usern4mehere9/LVPSU/README.md

# LVPSU
Low Voltage Power Supply Unit of Formula Student team "Black Hornets" from the University of Novi Sad Faculty of Technical Sciences
