usern4mehere9/LVPSU/LV_Kontrola_Main/README.md

# LV\_Kontrola

Low Voltage Power Supply Unit of Formula Student team "Black Hornets" from the University of Novi Sad Faculty of Technical Sciences

1. LV\_Kontrola\_Main connectors:

2\. LV\_Kontrola\_Infeed\_Battery connectors:

3\. LV\_Kontrola\_Start connectors:

START\_PWR:

1	\[GND]	GND\_START

2	\[GND]	GND\_START

3	\[GND]	GND\_START

4	\[GND]	GND\_START

5	\[VCC]	VCC\_START

6	\[VCC]	VCC\_START

7	\[VCC]	VCC\_START

8	\[VCC]	VCC\_START

COM:

1	\[GND]	GND\_START

2	\[COM]	RS485-B

3	\[GND]	GND\_START

4	\[COM]	RS485-A

START\_OUT\_A:

1	\[VCC]	5V4\_ISO\_1

2	\[GND]	GND\_ISO\_1

3	\[VCC]	5V4\_ISO\_2

4	\[GND]	GND\_ISO\_2

5	\[VCC]	5V4\_ISO\_3

6	\[GND]	GND\_ISO\_3

7	\[VCC]	5V4\_ISO\_4

8	\[GND]	GND\_ISO\_4

9	\[VCC]	3V7\_ISO\_1

10	\[GND]	GND\_ISO\_1

11	\[VCC]	3V7\_ISO\_2

12	\[GND]	GND\_ISO\_2

13	\[VCC]	3V7\_ISO\_3

14	\[GND]	GND\_ISO\_3

15	\[VCC]	3V7\_ISO\_4

16	\[GND]	GND\_ISO\_4

START\_OUT\_B:

1	\[VCC]	5V4\_ISO\_8

2	\[GND]	GND\_ISO\_8

3	\[VCC]	5V4\_ISO\_7

4	\[GND]	GND\_ISO\_7

5	\[VCC]	5V4\_ISO\_6

6	\[GND]	GND\_ISO\_6

7	\[VCC]	5V4\_ISO\_5

8	\[GND]	GND\_ISO\_5

9	\[VCC]	3V7\_ISO\_8

10	\[GND]	GND\_ISO\_8

11	\[VCC]	3V7\_ISO\_7

12	\[GND]	GND\_ISO\_7

13	\[VCC]	3V7\_ISO\_6

14	\[GND]	GND\_ISO\_6

15	\[VCC]	3V7\_ISO\_5

16	\[GND]	GND\_ISO\_5
