usern4mehere9/LVPSU/LV_Regulator/README.md

# LV\_Regulator

Low Voltage Power Supply Unit of Formula Student team "Black Hornets" from the University of Novi Sad Faculty of Technical Sciences

LV\_Regulator connectors:

PWR\_IN:

1	\[GND]	BAT-

2	\[GND]	BAT-

3	\[GND]	BAT-

4	\[GND]	BAT-

5	\[VCC]	BAT+

6	\[VCC]	BAT+

7	\[VCC]	BAT+

8	\[VCC]	BAT+

COM:

1	\[COM]	RS485-B

2	\[COM]	RS485-A

3	\[GND]	GND\_ISO

4	\[VCC]	+5V\_ISO

START:

1	\[GND]	GND

2	\[GND]	GND

3	\[VCC]	5V\_EXT

4	\[VCC]	3V3\_EXT

PWR\_OUT:

1	\[VCC]	VOUT

2	\[VCC]	VOUT

3	\[VCC]	VOUT

4	\[VCC]	VOUT

5	\[GND]	GND

6	\[GND]	GND

7	\[GND]	GND

8	\[GND]	GND
