usern4mehere9/LVPSU/Documentation/00-About.md

This folder is to be used for general documentation about the Low Voltage Power Supply
