usern4mehere9/LVPSU/LV_Regulator/Code/00-About.md

This folder is to be used for code files of the Low Voltage Power Supply regulator board
