usern4mehere9/LVPSU/LV_Regulator/Documentation/00-About.md

This folder is to be used for documentation about the Low Voltage Power Supply regulator board
