usern4mehere9/LVPSU/LV_Kontrola_Main/LV_Kontrola/Documentation/00-About.md

This folder is to be used for documentation about the Low Voltage Power Supply control board
