usern4mehere9/LVPSU/LV_Regulator/LV_Regulator/Components/00-About.md

This folder is to be used for component files of the Low Voltage Power Supply regulator board
