usern4mehere9/LVPSU/LV_Regulator/LV_Regulator/Manufacture/LV_Regulator_BoM.xlsx

Id | Designator | Footprint | Quantity | Designation | Supplier and ref
1 | 3V3 | LED_1206_3216Metric_Pad1.42x1.75mm_HandSolder | 1 | 3V3 (YELLOW) | https://www.digikey.com/en/products/detail/kingbright/APT3216YC/1747544 | https://eu.mouser.com/ProductDetail/Bivar/SM1206UYC?qs=jaLxTFIJCiuXlzWxYf0ziw%3D%3D
2 | 3V3_EXT | LED_1206_3216Metric_Pad1.42x1.75mm_HandSolder | 1 | 3V3_EXT (YELLOW) | https://www.digikey.com/en/products/detail/kingbright/APT3216YC/1747544 | https://eu.mouser.com/ProductDetail/Bivar/SM1206UYC?qs=jaLxTFIJCiuXlzWxYf0ziw%3D%3D
3 | 3V3_INT | LED_1206_3216Metric_Pad1.42x1.75mm_HandSolder | 1 | 3V3_INT (YELLOW) | https://www.digikey.com/en/products/detail/kingbright/APT3216YC/1747544 | https://eu.mouser.com/ProductDetail/Bivar/SM1206UYC?qs=jaLxTFIJCiuXlzWxYf0ziw%3D%3D
4 | 5V | LED_1206_3216Metric_Pad1.42x1.75mm_HandSolder | 1 | 5V (RED) | https://www.digikey.com/en/products/detail/kingbright/APT3216EC/1747854 | https://eu.mouser.com/ProductDetail/Bivar/SM1206URC?qs=jaLxTFIJCitAzd1qr2%2F7Jw%3D%3D
5 | 5V_EXT | LED_1206_3216Metric_Pad1.42x1.75mm_HandSolder | 1 | 5V_EXT (RED) | https://www.digikey.com/en/products/detail/kingbright/APT3216EC/1747854 | https://eu.mouser.com/ProductDetail/Bivar/SM1206URC?qs=jaLxTFIJCitAzd1qr2%2F7Jw%3D%3D
6 | 5V_INT | LED_1206_3216Metric_Pad1.42x1.75mm_HandSolder | 1 | 5V_INT (RED) | https://www.digikey.com/en/products/detail/kingbright/APT3216EC/1747854 | https://eu.mouser.com/ProductDetail/Bivar/SM1206URC?qs=jaLxTFIJCitAzd1qr2%2F7Jw%3D%3D
7 | C1, C2, C13, C14, C17, C18, C22, C24, C25 | C_1206_3216Metric_Pad1.33x1.80mm_HandSolder | 9 | 100nF | https://www.digikey.com/en/products/detail/kemet/c1206y104k9ractu/5879215 | https://eu.mouser.com/ProductDetail/KEMET/C1206Y104K9RACTU?qs=rUPLZ6nenJPIO9Oy%2FdArjw%3D%3D
8 | C3, C5, C19 | C_1206_3216Metric_Pad1.33x1.80mm_HandSolder | 3 | 0.1uF | https://www.digikey.com/en/products/detail/kemet/c1206y104k9ractu/5879215 | https://eu.mouser.com/ProductDetail/KEMET/C1206Y104K9RACTU?qs=rUPLZ6nenJPIO9Oy%2FdArjw%3D%3D
9 | C4, C6, C7, C10, C23 | C_1206_3216Metric_Pad1.33x1.80mm_HandSolder | 5 | 10uF | https://www.digikey.com/en/products/detail/samsung-electro-mechanics/CL31A106KQHNNWE/3888701 | https://eu.mouser.com/ProductDetail/Samsung-Electro-Mechanics/CL31A106KQHNNWE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
10 | C8, C11 | C_1206_3216Metric_Pad1.33x1.80mm_HandSolder | 2 | 47uF | https://www.digikey.com/en/products/detail/taiyo-yuden/MSASJ319LB5476MTNA01/22215176 | https://eu.mouser.com/ProductDetail/TAIYO-YUDEN/MLASJ319LB5476MTNA01?qs=tlsG%2FOw5FFj12GZbAd1Q9Q%3D%3D
11 | C9, C12 | C_1206_3216Metric_Pad1.33x1.80mm_HandSolder | 2 | 22uF | https://www.digikey.com/en/products/detail/murata-electronics/GCM31CD70J226KE02K/19115941 | https://eu.mouser.com/ProductDetail/Murata-Electronics/GGM31CD70J226KE02L?qs=efUn273yAheMi1mARkgjog%3D%3D
12 | C15, C20 | C_1206_3216Metric_Pad1.33x1.80mm_HandSolder | 2 | 8pF | https://www.digikey.com/en/products/detail/cal-chip-electronics-inc/GMC31CG8R0C50NT/25975036 | https://eu.mouser.com/ProductDetail/Walsin/1206N8R0B500CT?qs=ZrPdAQfJ6DNlIoaP9IseAQ%3D%3D
13 | C16, C21 | C_1206_3216Metric_Pad1.33x1.80mm_HandSolder | 2 | 12pF | https://www.digikey.com/en/products/detail/kyocera-avx/KGM31BCG1H120KT/1604417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 | https://eu.mouser.com/ProductDetail/KYOCERA-AVX/12065A120KAT2A?qs=KpoduxKdAk27g2uMv0%2FA4w%3D%3D
14 | C26, C27, C35, C36 | C_1206_3216Metric | 4 | 100nF | https://www.digikey.com/en/products/detail/kemet/c1206y104k9ractu/5879215 | https://eu.mouser.com/ProductDetail/KEMET/C1206Y104K9RACTU?qs=rUPLZ6nenJPIO9Oy%2FdArjw%3D%3D
15 | C28, C37 | C_1206_3216Metric | 2 | 4.7uF | https://www.digikey.com/en/products/detail/samsung-electro-mechanics/CL31B475KAHNNNE/3886713 | https://eu.mouser.com/ProductDetail/Walsin/SH31B475K250CT
16 | C29, C30 | C_1206_3216Metric | 2 | 1uF | https://www.digikey.com/en/products/detail/cal-chip-electronics-inc/GMT31X7R105K100NT2/26921703 | https://eu.mouser.com/ProductDetail/KEMET/C1206C105K1RAC7210?qs=u4fy%2FsgLU9Mgl3I%252Br1mPaw%3D%3D
17 | C31 | CAP_UCD_12P5X13P5_NCH | 1 | 56uF | https://www.digikey.com/en/products/detail/eaton-electronics-division/EHBSA080M5601010T/26408296 | https://eu.mouser.com/ProductDetail/Eaton-Electronics/EHBSA080M5601010T
18 | C32, C33 | CP_Elec_10x10 | 2 | 47uF | https://www.digikey.com/en/products/detail/vishay-beyschlag-draloric-bc-components/MAL214097801E3/5634876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 | https://eu.mouser.com/ProductDetail/Vishay-BC-Components/MAL214097801E3
19 | C34 | CAP_UCD_12P5X13P5_NCH | 1 | 180uF | https://www.digikey.com/en/products/detail/nichicon/ucz1j181mns1ms/13402701 | https://eu.mouser.com/ProductDetail/Nichicon/UCZ1J181MNS1MS?qs=DPoM0jnrROWw1nmvs2XGyw%3D%3D
20 | COM, START | CONN_SD-43045-001_04_MOL | 2 | 430450400 | https://www.digikey.com/en/products/detail/molex/0430450400/252527?s=N4IgTCBcDaICwGYAMcCsKlJAXQL5A | https://eu.mouser.com/ProductDetail/Molex/43045-0400?qs=UeCeOHRHQeaIqmxE9Bxdrw%3D%3D
21 | D1 | D_1206_3216Metric_Pad1.42x1.75mm_HandSolder | 1 | 1N4148 | https://www.digikey.com/en/products/detail/taiwan-semiconductor-corporation/1N4148WH-RHG/26257442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 | https://eu.mouser.com/ProductDetail/Taiwan-Semiconductor/1N4148WH-RHG?qs=jcD%2FCkGBYeO25pFAgr5eQA%3D%3D
22 | D2, D3, D4, D5, D6, D7 | CR_SMA_403AE_OSI | 6 | SS14 | https://www.digikey.com/en/products/detail/onsemi/SS14/965474 | https://eu.mouser.com/ProductDetail/onsemi/SS14?qs=mVVXn4M53U%252BvrBaFv5vr4w%3D%3D
23 | D8, D9 | D_1206_3216Metric_Pad1.42x1.75mm_HandSolder | 2 | LED(YELLOW) | https://www.digikey.com/en/products/detail/kingbright/APT3216YC/1747544 | https://eu.mouser.com/ProductDetail/Bivar/SM1206UYC?qs=jaLxTFIJCiuXlzWxYf0ziw%3D%3D
24 | DIAG | MOLEX_2169890001 | 1 | 2169890001 | https://www.digikey.com/en/products/detail/wec/216989-0001/29353332 | https://eu.mouser.com/ProductDetail/Molex/216989-0001?qs=DRkmTr78QARfehpd11NNIg%3D%3D
25 | ERR | LED_1206_3216Metric_Pad1.42x1.75mm_HandSolder | 1 | ERR(RED) | https://www.digikey.com/en/products/detail/kingbright/APT3216EC/1747854 | https://eu.mouser.com/ProductDetail/Bivar/SM1206URC?qs=jaLxTFIJCitAzd1qr2%2F7Jw%3D%3D
26 | F1 | Fuse_1206_3216Metric_Pad1.42x1.75mm_HandSolder | 1 | 8A | https://www.digikey.com/en/products/detail/bel-fuse-inc/C1F-8/4968262 | https://eu.mouser.com/ProductDetail/Bel-Fuse/C1F-8?qs=Mr%252BgrRYddfrdVmWsT7iZqg%3D%3D
27 | F2 | Fuse_1206_3216Metric_Pad1.42x1.75mm_HandSolder | 1 | 10A | https://www.digikey.com/en/products/detail/bel-fuse-inc/0685P9100-01/10057383 | https://eu.mouser.com/ProductDetail/Bel-Fuse/0685P9100-01?qs=vLWxofP3U2zpPXwWmInB2A%3D%3D
28 | F3, F4 | Fuse_1206_3216Metric_Pad1.42x1.75mm_HandSolder | 2 | 1A | https://www.digikey.com/en/products/detail/bel-fuse-inc/C1F-1/4968247 | https://eu.mouser.com/ProductDetail/Bel-Fuse/C1F-1?qs=Mr%252BgrRYddfo0MDG0o75HAg%3D%3D
29 | IC1 | SOIC127P1030X265-16N | 1 | UCC12040DVE | https://www.digikey.com/en/products/detail/texas-instruments/UCC12040DVE/11502272 | https://eu.mouser.com/ProductDetail/Texas-Instruments/UCC12040DVE?qs=xZ%2FP%252Ba9zWqaWnn41WPN4Eg%3D%3D
30 | IC2, IC3 | MIC29152WU | 2 | MIC29152WU | https://www.digikey.com/en/products/detail/microchip-technology/MIC29152WU/1029053 | https://eu.mouser.com/ProductDetail/Microchip-Technology/MIC29152WU?qs=kh6iOki%2FeLHeF19%2FNG7LNg%3D%3D
31 | J3, PWR_IN | CONN_SD-43045-001_08_MOL | 2 | 430450800 | https://www.digikey.com/en/products/detail/molex/0430450800/252529?s=N4IgTCBcDaICwGYAMcCsSAcSkgLoF8g | https://eu.mouser.com/ProductDetail/Molex/43045-0800?qs=MGlPTwjtJ4Z70Z3DbkGxKw%3D%3D
32 | K1 | LED_1206_3216Metric_Pad1.42x1.75mm_HandSolder | 1 | REL(GREEN) | https://www.digikey.com/en/products/detail/kingbright/APT3216SGC/1747540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 | https://eu.mouser.com/ProductDetail/Bivar/SM1206GC?qs=jaLxTFIJCisAdwYMDid7AA%3D%3D
33 | K1 | 415000000000 | 1 | 41.52.9.005.0010 | https://elektroleum.rs/proizvod/finder-41-52-9-005-0010-pcb-relej-5-v-dc-8-a-2-prekidac/ | //
34 | L1 | L_APV_APH1770 | 1 | 10uH | https://www.digikey.com/en/products/detail/bourns-inc/srp1770ta-100m/5429634 | https://eu.mouser.com/ProductDetail/Bourns/SRP1770TA-100M?qs=P%2FbxraXw5h21PnFfyxJ6Hw%3D%3D
35 | OK | LED_1206_3216Metric_Pad1.42x1.75mm_HandSolder | 1 | OK (GREEN) | https://www.digikey.com/en/products/detail/kingbright/APT3216SGC/1747540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 | https://eu.mouser.com/ProductDetail/Bivar/SM1206GC?qs=jaLxTFIJCisAdwYMDid7AA%3D%3D
36 | Q1 | SOT-23W_Handsoldering | 1 | BC807 | https://www.digikey.com/en/products/detail/onsemi/BC807-25LT1G/918336 | https://eu.mouser.com/ProductDetail/Rectron/BC807?qs=7pEAo90IqNGz%252BRZEzhTrXg%3D%3D
37 | R1, R3, R42, R43, R44, R45, R46, R47, R48 | R_1206_3216Metric_Pad1.30x1.75mm_HandSolder | 9 | --- | https://www.digikey.com/en/products/detail/yageo/rc1206jr-070rl/729184 | https://eu.mouser.com/ProductDetail/YAGEO/RC1206JR-070RL?qs=sGAEpiMZZMtlubZbdhIBIMHu9P6GKOabM4IOLvph3MY%3D
38 | R2 | R_1206_3216Metric_Pad1.30x1.75mm_HandSolder | 1 | 120 | https://www.digikey.com/en/products/detail/yageo/AC1206FR-07120RL/6006659 | https://eu.mouser.com/ProductDetail/YAGEO/RC1206JR-070RL?qs=sGAEpiMZZMtlubZbdhIBIMHu9P6GKOabM4IOLvph3MY%3D
39 | R4 | R_1206_3216Metric_Pad1.30x1.75mm_HandSolder | 1 | 4k7 | https://www.digikey.com/en/products/detail/yageo/RC1206DR-074K7L/5919134 | https://eu.mouser.com/ProductDetail/YAGEO/RE1206DRE074K7L?qs=sGAEpiMZZMtlubZbdhIBIKm0gsRX2fVkj2duGOZmAAU%3D
40 | R5 | R_1206_3216Metric_Pad1.30x1.75mm_HandSolder | 1 | 33k | https://www.digikey.com/en/products/detail/yageo/rt1206brd0733kl/1079747 | https://eu.mouser.com/ProductDetail/YAGEO/RT1206BRD0733KL
41 | R6, R53, R54 | R_1206_3216Metric_Pad1.30x1.75mm_HandSolder | 3 | 10k | https://www.digikey.com/en/products/detail/rohm-semiconductor/sfr18ezpj103/17139990 | https://eu.mouser.com/ProductDetail/ROHM-Semiconductor/SFR18EZPJ103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
42 | R7 | R_1206_3216Metric_Pad1.30x1.75mm_HandSolder | 1 | 34k | https://www.digikey.com/en/products/detail/panasonic-industry/era-8arw3402v/5163060 | https://eu.mouser.com/ProductDetail/Panasonic/ERA-8ARW3402V
43 | R8, R9, R24 | R_1206_3216Metric_Pad1.30x1.75mm_HandSolder | 3 | 10K | https://www.digikey.com/en/products/detail/rohm-semiconductor/sfr18ezpj103/17139990 | https://eu.mouser.com/ProductDetail/ROHM-Semiconductor/SFR18EZPJ103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
44 | R10, R12, R15 | R_1206_3216Metric_Pad1.30x1.75mm_HandSolder | 3 | 270 | https://www.digikey.com/en/products/detail/panasonic-industry/era-8aeb271v/3070925 | https://eu.mouser.com/ProductDetail/Panasonic/ERA-8AEB271V?qs=Ojoo2rCVP9QMqW%2FU5Qd6jQ%3D%3D
45 | R11, R13, R14, R16, R17, R18, R19, R20, R21 | R_1206_3216Metric_Pad1.30x1.75mm_HandSolder | 9 | 130 | https://www.digikey.com/en/products/detail/panasonic-industry/era-8aeb131v/3070785 | https://eu.mouser.com/ProductDetail/Panasonic/ERA-8AEB131V?qs=Ojoo2rCVP9TrpPj4XUmTEQ%3D%3D
46 | R22, R23 | R_1206_3216Metric_Pad1.30x1.75mm_HandSolder | 2 | 5K1 | https://www.digikey.com/en/products/detail/panasonic-industry/era-8arb512v/5141079 | https://eu.mouser.com/ProductDetail/Panasonic/ERA-8ARB512V?qs=6%252Bc%252B2ke79U5SMWj%2FkMBHmA%3D%3D
47 | R25, R26 | R_1206_3216Metric_Pad1.30x1.75mm_HandSolder | 2 | 27R | https://www.digikey.com/en/products/detail/panasonic-industry/era-8ahd270v/9373454 | https://eu.mouser.com/ProductDetail/Panasonic/ERA-8AHD270V?qs=MNPzkKEzRtQao2AraMolwQ%3D%3D
48 | R27 | R_1206_3216Metric_Pad1.30x1.75mm_HandSolder | 1 | 1K5 | https://www.digikey.com/en/products/detail/panasonic-industry/ERA-8ARB152V/5141066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 | https://eu.mouser.com/ProductDetail/Panasonic/ERA-8ARB152V?qs=O13OCoPxAUUWFoS4GUkTIg%3D%3D
49 | R28 | R_1206_3216Metric_Pad1.30x1.75mm_HandSolder | 1 | 132k | https://www.digikey.com/en/products/detail/vishay-dale/tnpw1206132kbeen/7663890 | https://eu.mouser.com/ProductDetail/Vishay/TNPW1206132KBEEN?qs=vgMJRbWkoi3MjsgVW2XhcQ%3D%3D
50 | R29 | R_1206_3216Metric_Pad1.30x1.75mm_HandSolder | 1 | 67k | https://www.digikey.com/en/products/detail/yageo/rt1206fre0766k5l/1083325 | https://eu.mouser.com/ProductDetail/YAGEO/RT1206FRE0766K5L?qs=yNCrj0CQcyI8FCz1oyla5w%3D%3D
51 | R30 | R_1206_3216Metric_Pad1.30x1.75mm_HandSolder | 1 | 100k | https://www.digikey.com/en/products/detail/koa-speer-electronics-inc/RN73H2BTTD1003B25/10064206 | https://eu.mouser.com/ProductDetail/KOA-Speer/RN73H2BTTD1003B25?qs=G1LhLIAbs1wIuuYtOEogfA%3D%3D
52 | R31 | R_1206_3216Metric_Pad1.30x1.75mm_HandSolder | 1 | 57k | https://www.digikey.com/en/products/detail/panasonic-industry/ERA-8AEB5762V/3071099 | https://eu.mouser.com/ProductDetail/KOA-Speer/RN73H2BTTD5762B50?qs=rI7uf1IzohRjg5ImrTOTZw%3D%3D
53 | R32, R39 | R_1206_3216Metric_Pad1.30x1.75mm_HandSolder | 2 | 1M | https://www.digikey.com/en/products/detail/te-connectivity-passive-product/CRG1206F1M0/2380979 | https://eu.mouser.com/ProductDetail/KOA-Speer/RK73G2BRTTD1004F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
54 | R33 | R_1206_3216Metric_Pad1.30x1.75mm_HandSolder | 1 | 115k | https://www.digikey.com/en/products/detail/yageo/RC1206FR-07115KL/728512 | https://eu.mouser.com/ProductDetail/KOA-Speer/RN73H2BTTD1153F100?qs=egkD4cx1ihRrPVr9m6Kwpw%3D%3D
55 | R34, R36 | R_1206_3216Metric_Pad1.30x1.75mm_HandSolder | 2 | 1k | https://www.digikey.com/en/products/detail/koa-speer-electronics-inc/RN73R2BTTD1001B25/10038824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 | https://eu.mouser.com/ProductDetail/KOA-Speer/RN73R2BTTD1001B25?qs=2WXlatMagcH37CMjW4no9w%3D%3D
56 | R35, R41 | R_1206_3216Metric_Pad1.30x1.75mm_HandSolder | 2 | 22k | https://www.digikey.com/en/products/detail/yageo/RT1206FRD0722KL/21768884 | https://eu.mouser.com/ProductDetail/KOA-Speer/RN73H2BTTD2202F100?qs=egkD4cx1ihQzyZ5aSCTtGw%3D%3D
57 | R37 | R_1206_3216Metric_Pad1.30x1.75mm_HandSolder | 1 | 80k | https://www.digikey.com/en/products/detail/koa-speer-electronics-inc/RN73H2BTTD8062F50/10104981 | https://eu.mouser.com/ProductDetail/KOA-Speer/RN73H2BTTD8062F50?qs=egkD4cx1ihTPwGpTlMv%2FKg%3D%3D
58 | R38 | R_1206_3216Metric_Pad1.30x1.75mm_HandSolder | 1 | 30k | https://www.digikey.com/en/products/detail/yageo/RT1206BRD0730KL/1079730 | https://eu.mouser.com/ProductDetail/KOA-Speer/RN73R2BTTD5002B25?qs=2WXlatMagcHXnQ1HwYzmYA%3D%3D
59 | R40 | R_1206_3216Metric_Pad1.30x1.75mm_HandSolder | 1 | 311k | https://www.digikey.com/en/products/detail/koa-speer-electronics-inc/rn73h2bttd3123f50/10098239 | https://eu.mouser.com/ProductDetail/KOA-Speer/RN73H2BTTD3123F50?qs=egkD4cx1ihSun6G6xPVr3A%3D%3D
60 | R49 | R_1206_3216Metric_Pad1.30x1.75mm_HandSolder | 1 | 2.2k | https://www.digikey.com/en/products/detail/yageo/RT1206DRE072K2L/1082537 | https://eu.mouser.com/ProductDetail/Panasonic/ERA-8AED222V?qs=MNPzkKEzRtQm0146O%252BqXeg%3D%3D
61 | R50 | RESC50110X70N | 1 | 5m | https://www.digikey.com/en/products/detail/ohmite/FCSL110R005FER/2352241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 | https://eu.mouser.com/ProductDetail/Ohmite/FCSL110R005FER?qs=MhoRK8A7%252BtWFd3RnyGifNg%3D%3D
62 | R51, R52 | R_1206_3216Metric_Pad1.30x1.75mm_HandSolder | 2 | 10 | https://www.digikey.com/en/products/detail/panasonic-industry/ERA-8AHD100V/9373445 | https://eu.mouser.com/ProductDetail/Panasonic/ERA-8AHD100V?qs=MNPzkKEzRtQgblvRJLtuOQ%3D%3D
63 | RUN | LED_1206_3216Metric_Pad1.42x1.75mm_HandSolder | 1 | RUN(GREEN) | https://www.digikey.com/en/products/detail/kingbright/APT3216SGC/1747540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 | https://eu.mouser.com/ProductDetail/Bivar/SM1206GC?qs=jaLxTFIJCisAdwYMDid7AA%3D%3D
64 | RX | LED_1206_3216Metric_Pad1.42x1.75mm_HandSolder | 1 | RX(RED) | https://www.digikey.com/en/products/detail/kingbright/APT3216EC/1747854 | https://eu.mouser.com/ProductDetail/Bivar/SM1206URC?qs=jaLxTFIJCitAzd1qr2%2F7Jw%3D%3D
65 | SWD | PinHeader_1x04_P2.54mm_Vertical | 1 | SWD | https://www.digikey.com/en/products/detail/te-connectivity-amp-connectors/826646-2/2276168 | https://eu.mouser.com/ProductDetail/TE-Connectivity/826646-2?qs=6Tj7fpyCzVqaIPUaVSFNTg%3D%3D
66 | TX | LED_1206_3216Metric_Pad1.42x1.75mm_HandSolder | 1 | TX(YELLOW) | https://www.digikey.com/en/products/detail/kingbright/APT3216YC/1747544 | https://eu.mouser.com/ProductDetail/Kingbright/APT3216YC?qs=fKJLI%2FsxXOfMof1%252BHeqe1A%3D%3D
67 | U1 | SOIC-16W_7.5x10.3mm_P1.27mm | 1 | ADM2483xRW | https://www.digikey.com/en/products/detail/analog-devices-inc/ADM2483BRWZ/1007303 | https://eu.mouser.com/ProductDetail/Analog-Devices/ADM2483BRWZ-REEL?qs=BpaRKvA4VqG%252BMd7ITKpptQ%3D%3D
68 | U2 | LQFP-48_7x7mm_P0.5mm | 1 | STM32F103C8Tx | https://www.digikey.com/en/products/detail/stmicroelectronics/STM32F103C8T6/1646338 | https://eu.mouser.com/ProductDetail/STMicroelectronics/STM32F103C8T6?qs=bhCVus9SdFtq6kqxsU5%2FDA%3D%3D
69 | U3 | SOIC-8_3.9x4.9mm_P1.27mm | 1 | 25CSM04xxSN | https://www.digikey.com/en/products/detail/microchip-technology/25CSM04T-I-SN/13174945 | https://eu.mouser.com/ProductDetail/Microchip-Technology/25CSM04T-I-SN?qs=W%2FMpXkg%252BdQ4COJ43XO1dvg%3D%3D
70 | U4 | RRV0036B-IPC_A | 1 | BQ25858QWRRVRQ1 | https://www.digikey.com/en/products/detail/texas-instruments/BQ25858QWRRVRQ1/26639671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 | https://eu.mouser.com/ProductDetail/Texas-Instruments/BQ25858QWRRVRQ1?qs=2FehpBK1j95O8UCrfNTgvw%3D%3D
71 | U5, U6, U7, U8 | DDPAK&slash_TO-263_KTT_TEX | 4 | CSD19506KTT | https://www.digikey.com/en/products/detail/texas-instruments/CSD19506KTT/5970302
72 | Y1 | Crystal_SMD_EuroQuartz_EQ161-2Pin_3.2x1.5mm_HandSoldering | 1 | 32.768kHz | https://www.digikey.com/en/products/detail/seiko-instruments/SC32S-7PF20PPM/4931504 | https://eu.mouser.com/ProductDetail/Seiko-Instruments/SC32A-6PF20PPM?qs=Imq1NPwxi76SI853puRy%252Bw%3D%3D
73 | Y2 | Crystal_SMD_5032-2Pin_5.0x3.2mm_HandSoldering | 1 | 8MHz | https://www.digikey.com/en/products/detail/ecs-inc/ECS-80-8-30-JGN-TR/17139414 | https://eu.mouser.com/ProductDetail/ECS/ECS-80-8-30-JGN-TR?qs=rQFj71Wb1eX34%2FP%2F%2Fw8%2FDA%3D%3D
74
75
76
77
78
79
80
81
82
