usern4mehere9/LVPSU/LV_Regulator/LV_Regulator/Components/LIB_41.52.9.005.0010/41.52.9.005.0010/3D/41.52.9.005.0010.stp

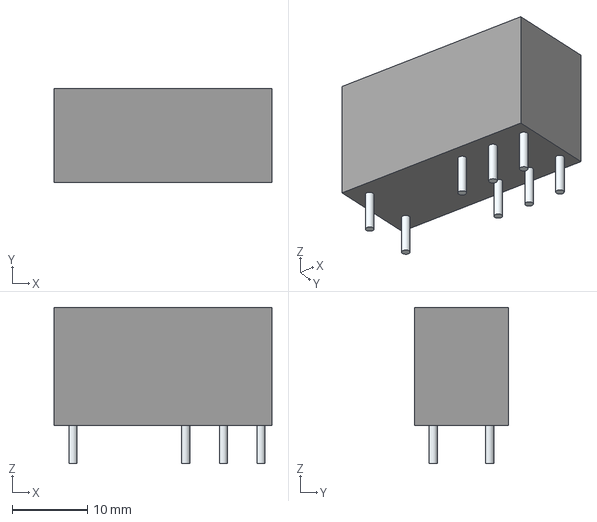
[picture p66: CAD file, 2026-01-20]
LV_Regulator/LV_Regulator/Components/LIB_41.52.9.005.0010/41.52.9.005.0010/3D/41.52.9.005.0010.stp
29.0 x 12.5 x 20.8 mm
Leads
