usern4mehere9/LVPSU/LV_Regulator/LV_Regulator/Components/LIB_FCSL110R005FER/FCSL110R005FER/3D/FCSL110R005FER.stp

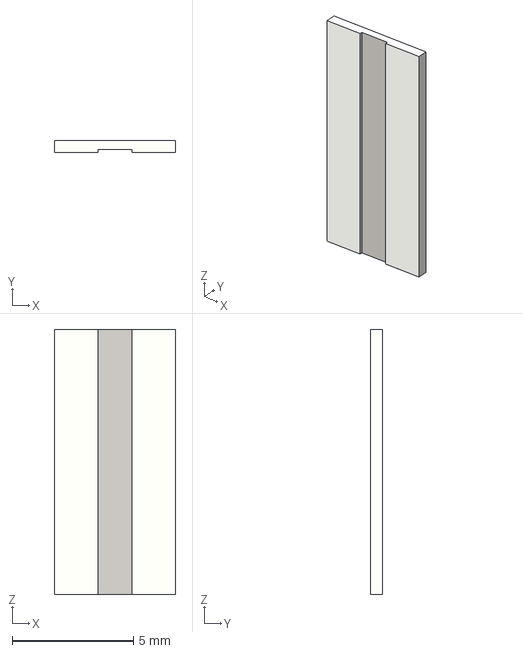
[picture p67: CAD file, 2026-03-20]
LV_Regulator/LV_Regulator/Components/LIB_FCSL110R005FER/FCSL110R005FER/3D/FCSL110R005FER.stp
5.00 x 0.5 x 10.9 mm
