usern4mehere9/LVPSU/LV_Regulator/LV_Regulator/Components/LIB_SC32A-6PF20PPM/SC32A-6PF20PPM/3D/SC32A-6PF20PPM.stp

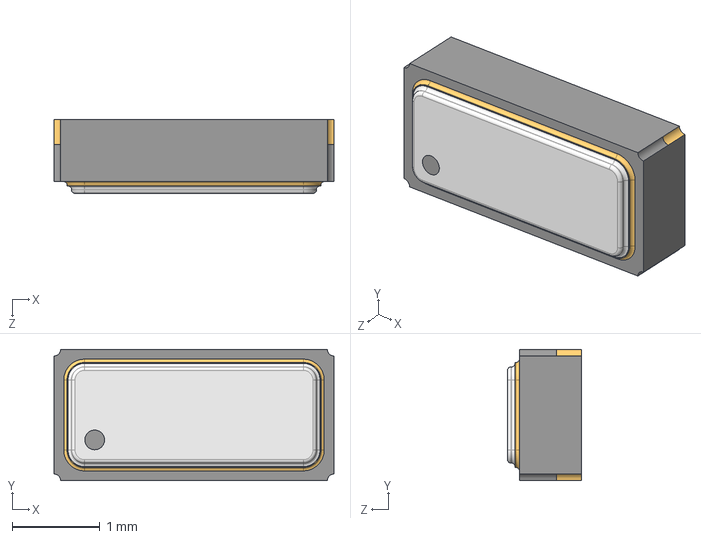
[picture p68: CAD file, 2026-03-29]
LV_Regulator/LV_Regulator/Components/LIB_SC32A-6PF20PPM/SC32A-6PF20PPM/3D/SC32A-6PF20PPM.stp
3.20 x 1.50 x 0.845 mm
