usern4mehere9/LVPSU/LV_Regulator/LV_Regulator/Components/SS14/Schottky Diode.step

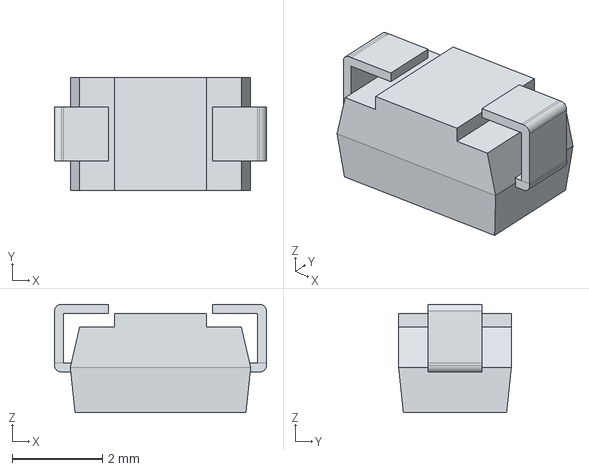
[picture p69: CAD file, 2026-03-29]
LV_Regulator/LV_Regulator/Components/SS14/Schottky Diode.step
4.70 x 2.50 x 2.40 mm
