usern4mehere9/LVPSU/LV_Regulator/LV_Regulator/Components/ul_BQ25858QWRRVRQ1/Texas_RHH0036C_VQFN-36-1EP_6x6mm_P0.5mm_EP4.4x4.4mm.step

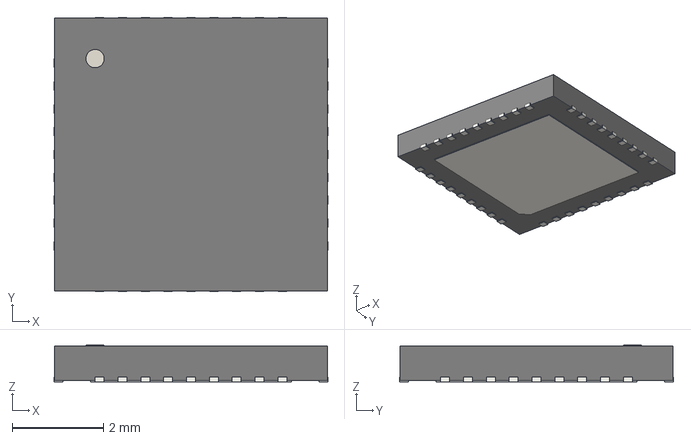
[picture p70: CAD file, 2026-03-28]
LV_Regulator/LV_Regulator/Components/ul_BQ25858QWRRVRQ1/Texas_RHH0036C_VQFN-36-1EP_6x6mm_P0.5mm_EP4.4x4.4mm.step
6.00 x 6.00 x 0.8 mm
