usern4mehere9/LVPSU/LV_Regulator/LV_Regulator/Components/ul_CSD19506KTT/KTT0002A.stp

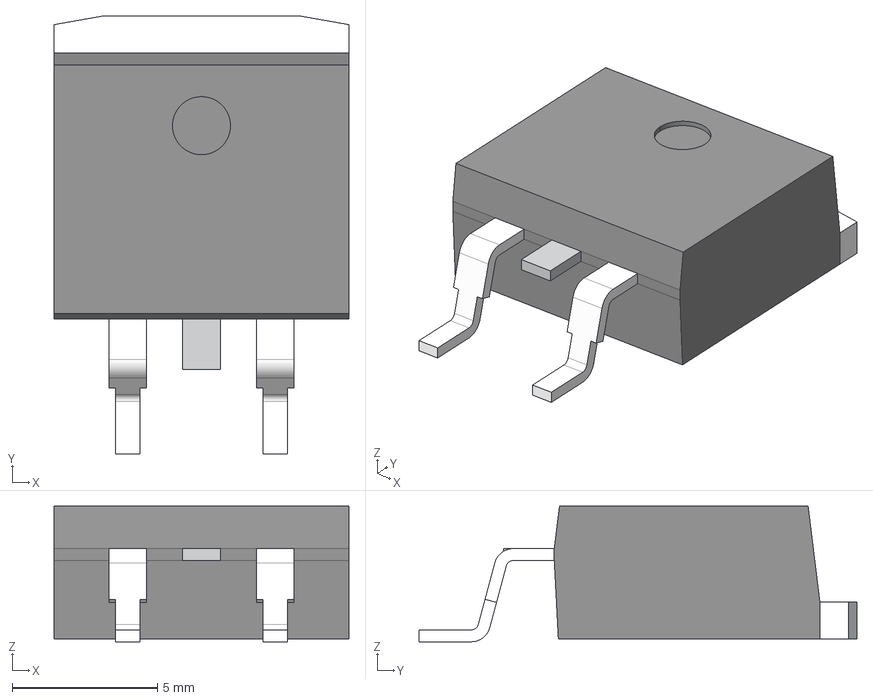
[picture p71: CAD file, 2026-03-28]
LV_Regulator/LV_Regulator/Components/ul_CSD19506KTT/KTT0002A.stp
10.2 x 15.1 x 4.67 mm
BODY-TO263
HTSINK-TO263
LEAD-TO263 x 2
LEAD-MIDDLE
