usern4mehere9/LVPSU/LV_Regulator/LV_Regulator/Components/ul_UCZ1J181MNQ1MS/UCZ1J181MNS1MS_Vibration_resistant.step

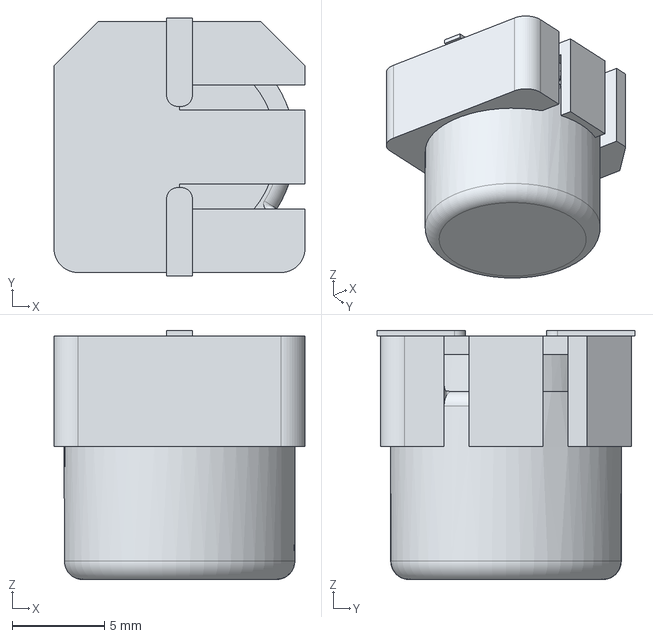
[picture p72: CAD file, 2026-03-29]
LV_Regulator/LV_Regulator/Components/ul_UCZ1J181MNQ1MS/UCZ1J181MNS1MS_Vibration_resistant.step
13.6 x 14.0 x 13.5 mm
