usern4mehere9/LVPSU/LV_Regulator/LV_Regulator/Components/V1FM10-M3_H/LIB_V1FM10-M3_H/V1FM10-M3_H/3D/V1FM10-M3_H.stp

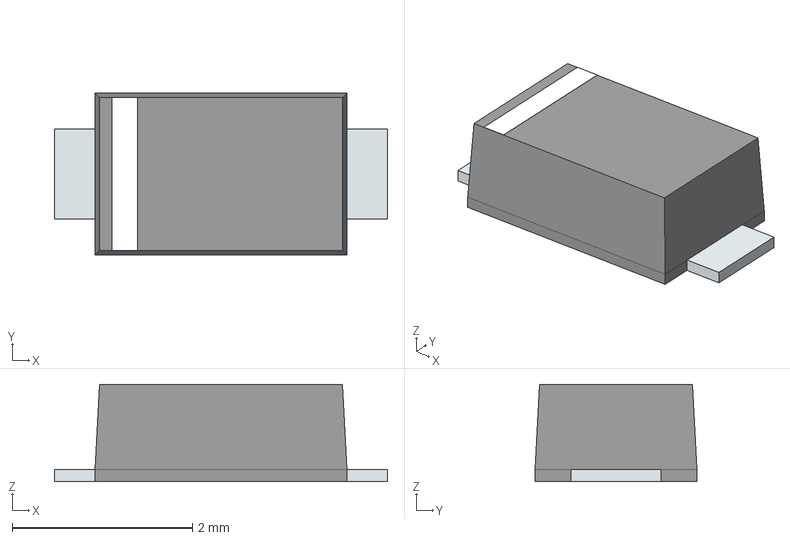
[picture p73: CAD file, 2026-03-27]
LV_Regulator/LV_Regulator/Components/V1FM10-M3_H/LIB_V1FM10-M3_H/V1FM10-M3_H/3D/V1FM10-M3_H.stp
3.70 x 1.80 x 1.08 mm
PinKIdent
PinK
PinA
