usern4mehere9/LVPSU/LV_Regulator/LV_Regulator/Components/ul_BQ25858QWRRVRQ1/QFN-36-1EP_5x6mm_P0.5mm_EP3.6x4.6mm.step

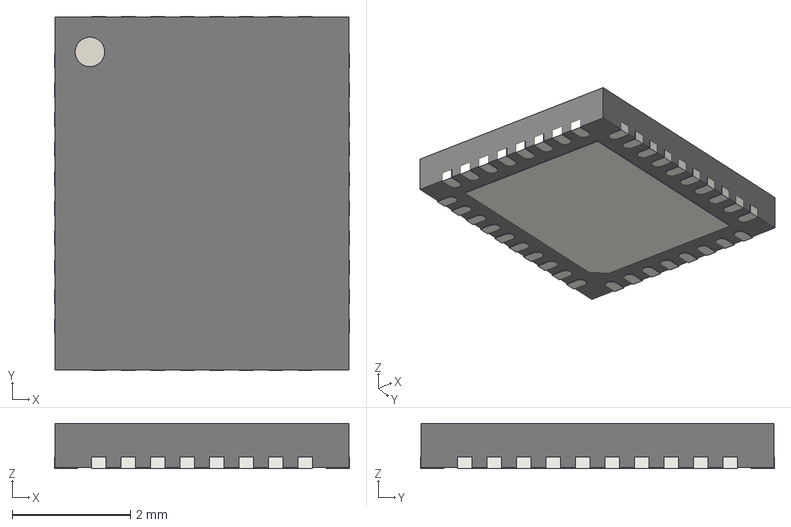
[picture p74: CAD file, 2026-03-28]
LV_Regulator/LV_Regulator/Components/ul_BQ25858QWRRVRQ1/QFN-36-1EP_5x6mm_P0.5mm_EP3.6x4.6mm.step
5.00 x 6.00 x 0.77 mm
