usern4mehere9/LVPSU/LV_Kontrola_Main/LV_Kontrola_Start/LV_Kontrola_Start/Components/430451600/430451600.step

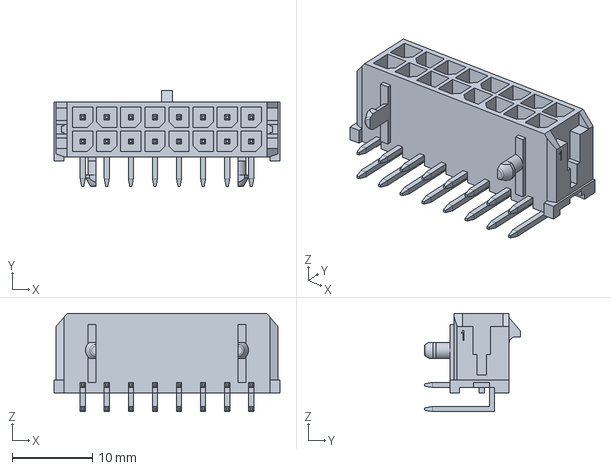
[picture p75: CAD file, 2026-04-07]
LV_Kontrola_Main/LV_Kontrola_Start/LV_Kontrola_Start/Components/430451600/430451600.step
28.2 x 12.0 x 12.2 mm
