usern4mehere9/LVPSU/LV_Kontrola_Main/LV_Kontrola_Start/LV_Kontrola_Start/Components/LIB_MIC29152WU/MIC29152WU/3D/MIC29152WU.stp

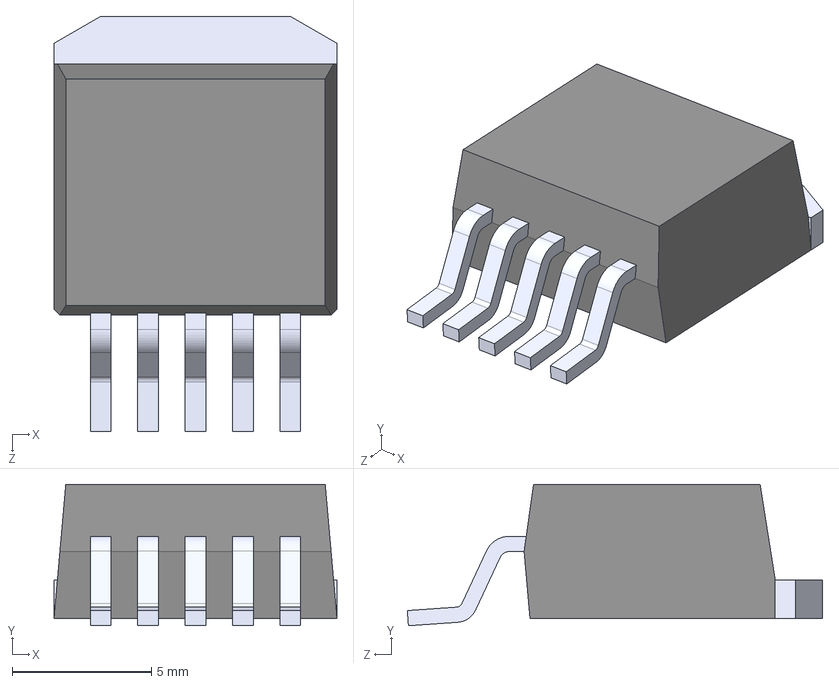
[picture p76: CAD file, 2026-03-18]
LV_Kontrola_Main/LV_Kontrola_Start/LV_Kontrola_Start/Components/LIB_MIC29152WU/MIC29152WU/3D/MIC29152WU.stp
10.2 x 5.08 x 14.9 mm
