usern4mehere9/LVPSU/LV_Kontrola_Main/LV_Kontrola_Start/LV_Kontrola_Start/Components/LIB_UCC12040DVE/UCC12040DVE/3D/UCC12040DVE.stp

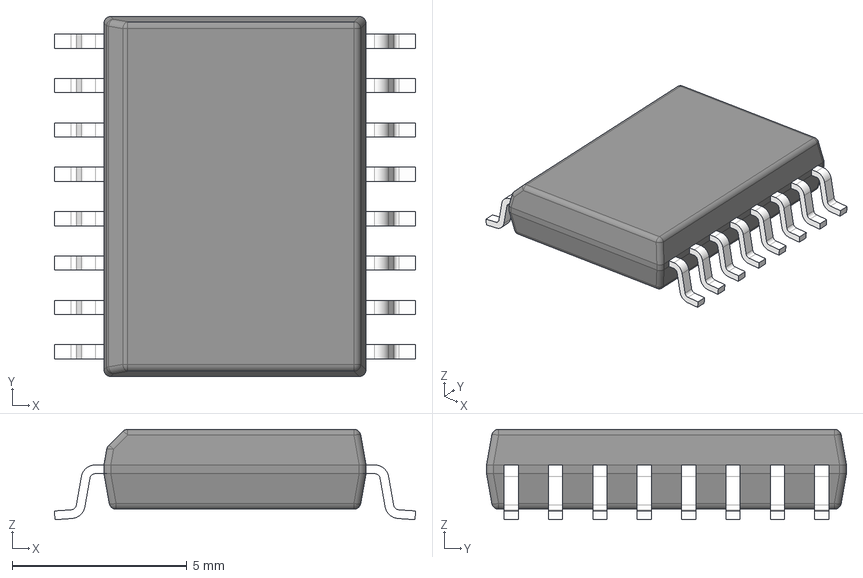
[picture p77: CAD file, 2026-01-20]
LV_Kontrola_Main/LV_Kontrola_Start/LV_Kontrola_Start/Components/LIB_UCC12040DVE/UCC12040DVE/3D/UCC12040DVE.stp
10.3 x 10.3 x 2.59 mm
BODY-DVE0016A
LEAD-DVE0016A x 16
