usern4mehere9/LVPSU/LV_Kontrola_Main/LV_Kontrola_Start/LV_Kontrola_Start/Components/microfit-4pin/430450401--3DModel-STEP-269445.STEP

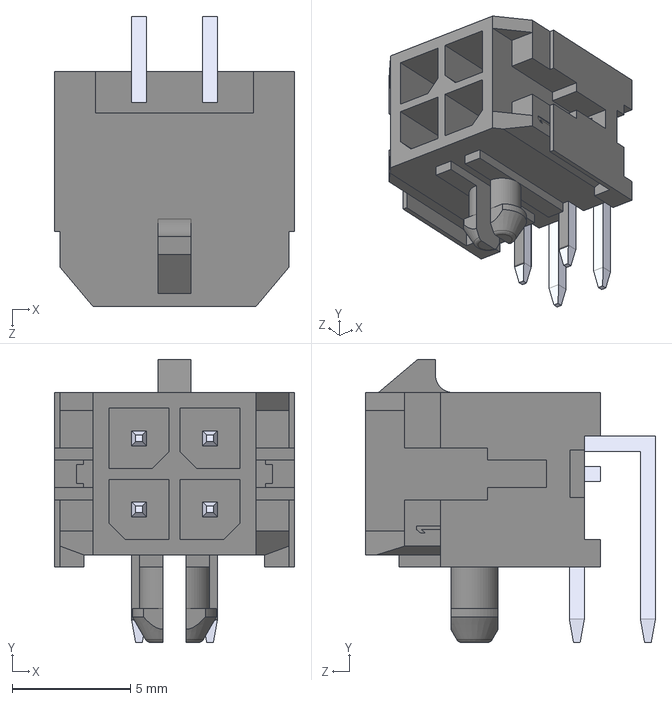
[picture p78: CAD file, 2026-03-28]
LV_Kontrola_Main/LV_Kontrola_Start/LV_Kontrola_Start/Components/microfit-4pin/430450401--3DModel-STEP-269445.STEP
10.2 x 12.0 x 12.2 mm
