usern4mehere9/LVPSU/LV_Kontrola_Main/LV_Kontrola_Start/LV_Kontrola_Start/Components/microfit-8pin/430450800--3DModel-STEP-56544.STEP

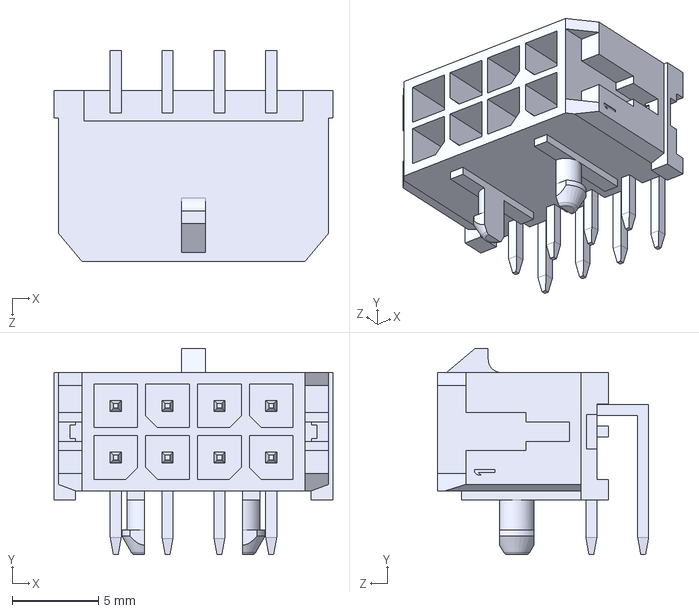
[picture p79: CAD file, 2026-03-28]
LV_Kontrola_Main/LV_Kontrola_Start/LV_Kontrola_Start/Components/microfit-8pin/430450800--3DModel-STEP-56544.STEP
16.2 x 11.9 x 12.2 mm
