usern4mehere9/LVPSU/LV_Kontrola_Main/LV_Kontrola_Start/LV_Kontrola_Start/Components/USB-C/2169890001.step

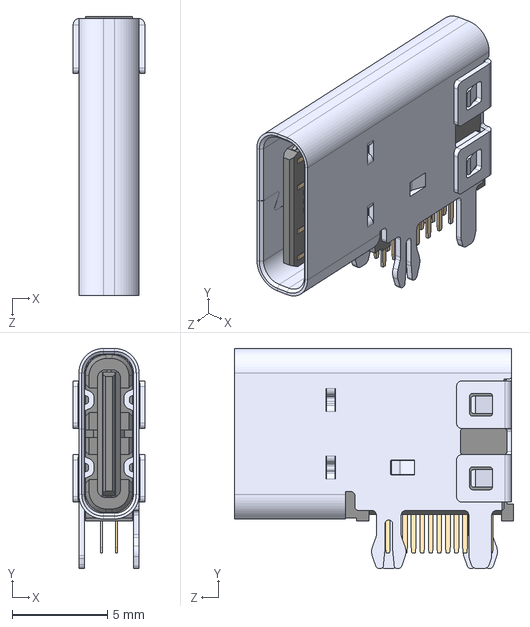
[picture p80: CAD file, 2026-03-03]
LV_Kontrola_Main/LV_Kontrola_Start/LV_Kontrola_Start/Components/USB-C/2169890001.step
3.76 x 11.5 x 14.6 mm
