usern4mehere9/LVPSU/(list of files, cad)

Other CAD files:
LV_Regulator/Documentation/Board_layout_draft.dwg
LV_Kontrola_Main/LV_Kontrola_Start/LV_Kontrola_Start/Components/LIB_MIC29152WU/MIC29152WU/Allegro/mic29152wu.psm
LV_Kontrola_Main/LV_Kontrola_Start/LV_Kontrola_Start/Components/LIB_MIC29152WU/MIC29152WU/DEHDL/mic29152wu/chips/chips.prt
LV_Kontrola_Main/LV_Kontrola_Start/LV_Kontrola_Start/Components/LIB_UCC12040DVE/UCC12040DVE/Allegro/soic127p1030x265-16n.psm
LV_Kontrola_Main/LV_Kontrola_Start/LV_Kontrola_Start/Components/LIB_UCC12040DVE/UCC12040DVE/DEHDL/ucc12040dve/chips/chips.prt
LV_Regulator/LV_Regulator/Components/LIB_41.52.9.005.0010/41.52.9.005.0010/Allegro/415290050010.psm
LV_Regulator/LV_Regulator/Components/LIB_41.52.9.005.0010/41.52.9.005.0010/DEHDL/41.52.9.005.0010/chips/chips.prt
LV_Regulator/LV_Regulator/Components/LIB_FCSL110R005FER/FCSL110R005FER/Allegro/resc50110x70n.psm
LV_Regulator/LV_Regulator/Components/LIB_FCSL110R005FER/FCSL110R005FER/DEHDL/fcsl110r005fer/chips/chips.prt
LV_Regulator/LV_Regulator/Components/LIB_MIC29152WU/MIC29152WU/Allegro/mic29152wu.psm
LV_Regulator/LV_Regulator/Components/LIB_MIC29152WU/MIC29152WU/DEHDL/mic29152wu/chips/chips.prt
LV_Regulator/LV_Regulator/Components/LIB_UCC12040DVE/UCC12040DVE/Allegro/soic127p1030x265-16n.psm
LV_Regulator/LV_Regulator/Components/LIB_UCC12040DVE/UCC12040DVE/DEHDL/ucc12040dve/chips/chips.prt
LV_Regulator/LV_Regulator/Components/V1FM10-M3_H/LIB_V1FM10-M3_H/V1FM10-M3_H/Allegro/sodfl3718x108n.psm
LV_Regulator/LV_Regulator/Components/V1FM10-M3_H/LIB_V1FM10-M3_H/V1FM10-M3_H/DEHDL/v1fm10_m3_h/chips/chips.prt
