usern4mehere9/LVPSU/(list of files, drawings)

Other design files:
LV_Kontrola_Main/LV_Kontrola_Start/LV_Kontrola_Start/Components/LIB_MIC29152WU/MIC29152WU/Altium/MIC29152WU.PcbLib
LV_Kontrola_Main/LV_Kontrola_Start/LV_Kontrola_Start/Components/LIB_MIC29152WU/MIC29152WU/Altium/MIC29152WU.SchLib
LV_Kontrola_Main/LV_Kontrola_Start/LV_Kontrola_Start/Components/LIB_UCC12040DVE/UCC12040DVE/Altium/SOIC127P1030X265-16N.PcbLib
LV_Kontrola_Main/LV_Kontrola_Start/LV_Kontrola_Start/Components/LIB_UCC12040DVE/UCC12040DVE/Altium/UCC12040DVE.SchLib
LV_Regulator/LV_Regulator/Components/LIB_FCSL110R005FER/FCSL110R005FER/Altium/FCSL110R005FER.SchLib
LV_Regulator/LV_Regulator/Components/LIB_FCSL110R005FER/FCSL110R005FER/Altium/RESC50110X70N.PcbLib
LV_Regulator/LV_Regulator/Components/LIB_MIC29152WU/MIC29152WU/Altium/MIC29152WU.PcbLib
LV_Regulator/LV_Regulator/Components/LIB_MIC29152WU/MIC29152WU/Altium/MIC29152WU.SchLib
LV_Regulator/LV_Regulator/Components/LIB_UCC12040DVE/UCC12040DVE/Altium/SOIC127P1030X265-16N.PcbLib
LV_Regulator/LV_Regulator/Components/LIB_UCC12040DVE/UCC12040DVE/Altium/UCC12040DVE.SchLib
LV_Regulator/LV_Regulator/Components/V1FM10-M3_H/LIB_V1FM10-M3_H/V1FM10-M3_H/Altium/SODFL3718X108N.PcbLib
LV_Regulator/LV_Regulator/Components/V1FM10-M3_H/LIB_V1FM10-M3_H/V1FM10-M3_H/Altium/V1FM10-M3_H.SchLib
