usern4mehere9/LVPSU/LV_Kontrola_Main/LV_Kontrola_Start/LV_Kontrola_Start/LV_Kontrola_Start.kicad_pcb

## KiCad design LV_Kontrola_Main/LV_Kontrola_Start/LV_Kontrola_Start/LV_Kontrola_Start.kicad_pcb (2026-06-05)

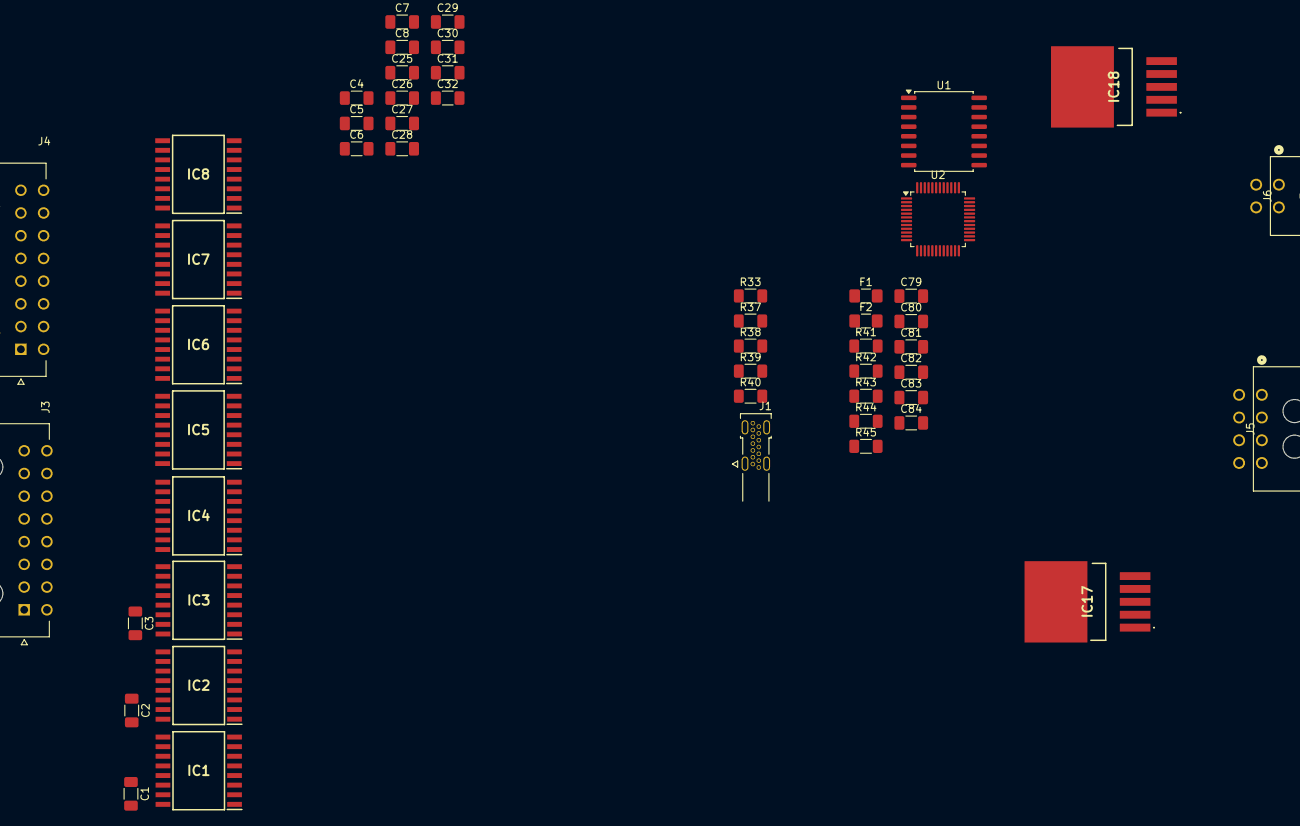
[picture p81: board LV_Kontrola_Start.kicad_pcb from above]

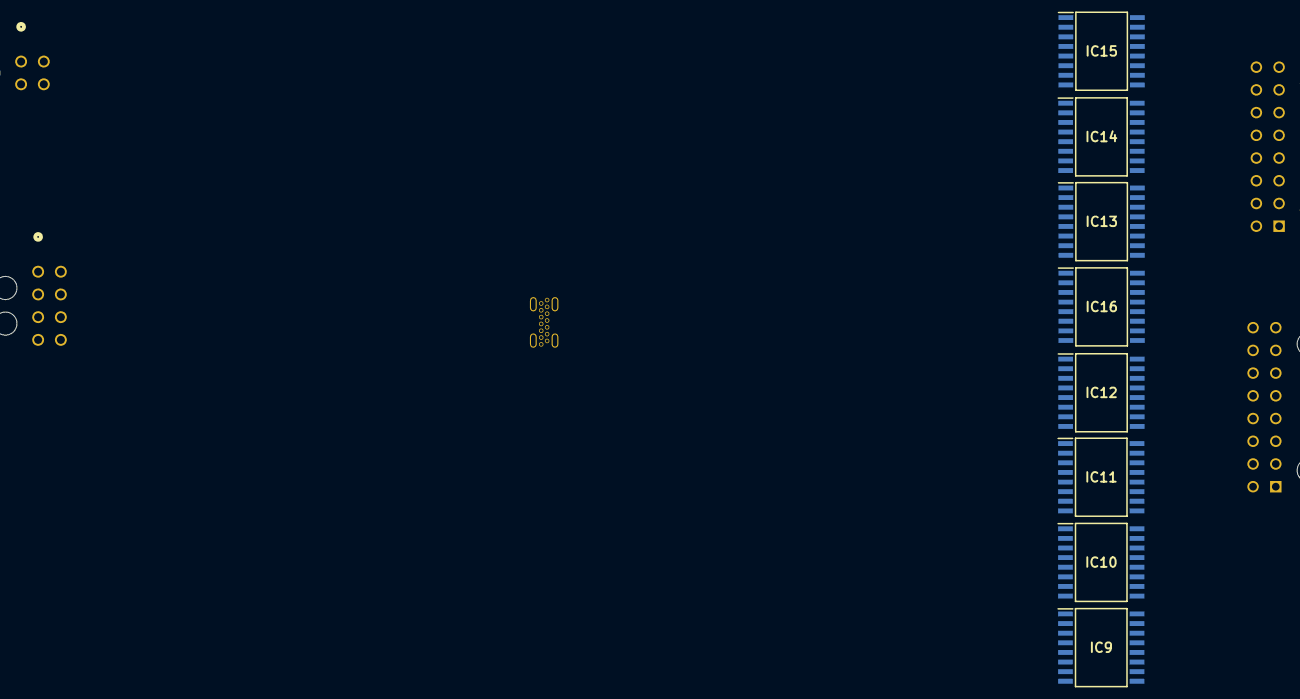
[picture p82: board LV_Kontrola_Start.kicad_pcb from below]

Board: 2 copper layers, 59 parts (8 on the bottom side), 44 nets, no tracks yet.

Parts:
C1, C2, C3, C4, C29, C30, C31, C32: 0.1uF; C_1206_3216Metric_Pad1.33x1.80mm_HandSolder
C5, C6, C7, C8, C25, C26, C27, C28, C81, C84: 10uF; C_1206_3216Metric_Pad1.33x1.80mm_HandSolder
C79, C82: 47uF; C_1206_3216Metric_Pad1.33x1.80mm_HandSolder
C80, C83: 22uF; C_1206_3216Metric_Pad1.33x1.80mm_HandSolder
F1, F2: 1A; Fuse_1206_3216Metric_Pad1.42x1.75mm_HandSolder
IC1, IC2, IC3, IC4, IC5, IC6, IC7, IC8, IC9, IC10, IC11, IC12, IC13, IC14, IC15, IC16: UCC12040DVE; SOIC127P1030X265-16N
IC17, IC18: MIC29152WU
J1: 2169890001; MOLEX_2169890001
J3, J4: 430451600; MOLEX_430451600
J5: 430450800; CONN_SD-43045-001_08_MOL
J6: 430450400; CONN_SD-43045-001_04_MOL
R33, R40: 5K1; R_1206_3216Metric_Pad1.30x1.75mm_HandSolder
R37, R38: 27R; R_1206_3216Metric_Pad1.30x1.75mm_HandSolder
R39: 1K5; R_1206_3216Metric_Pad1.30x1.75mm_HandSolder
R41: 34k; R_1206_3216Metric_Pad1.30x1.75mm_HandSolder
R42, R43: 10K; R_1206_3216Metric_Pad1.30x1.75mm_HandSolder
R44: 33k; R_1206_3216Metric_Pad1.30x1.75mm_HandSolder
R45: 10k; R_1206_3216Metric_Pad1.30x1.75mm_HandSolder
U1: ADM2483xRW; SOIC-16W_7.5x10.3mm_P1.27mm
U2: STM32F103C8Tx; LQFP-48_7x7mm_P0.5mm

Connections:
+3V7_ISO1: IC9.14 (VISO), J3.9
+3V7_ISO2: IC10.14 (VISO), J3.11
+3V7_ISO3: IC11.14 (VISO), J3.13
+3V7_ISO4: IC12.14 (VISO), J3.15
+3V7_ISO5: IC15.14 (VISO), J4.15
+3V7_ISO6: IC14.14 (VISO), J4.13
+3V7_ISO7: IC13.14 (VISO), J4.11
+3V7_ISO8: IC16.14 (VISO), J4.9
+5V4_ISO1: C1.1, C5.1, IC1.14 (VISO), J3.1
+5V4_ISO2: C2.1, C6.1, IC2.14 (VISO), J3.3
+5V4_ISO3: C3.1, C7.1, IC3.14 (VISO), J3.5
+5V4_ISO4: C4.1, C8.1, IC4.14 (VISO), J3.7
+5V4_ISO5: C28.1, C32.1, IC8.14 (VISO), J4.7
+5V4_ISO6: C27.1, C31.1, IC7.14 (VISO), J4.5
+5V4_ISO7: C26.1, C30.1, IC6.14 (VISO), J4.3
+5V4_ISO8: C25.1, C29.1, IC5.14 (VISO), J4.1
+5V_START: C82.2, F2.2, IC1.3 (VINP), IC2.3 (VINP), IC3.3 (VINP), IC4.3 (VINP), IC5.3 (VINP), IC6.3 (VINP), IC7.3 (VINP), IC8.3 (VINP), IC9.3 (VINP), IC10.3 (VINP), IC11.3 (VINP), IC12.3 (VINP), IC13.3 (VINP), IC14.3 (VINP), IC15.3 (VINP), IC16.3 (VINP), U1.16 (VDD2)
+V_START: C81.2, C84.2, IC17.2 (IN), IC18.2 (IN), J5.5, J5.6, J5.7, J5.8
CON_DN: J1.A7 (DA-), J1.B7 (DB-), R37.1
CON_DP: J1.A6 (DA+), J1.B6 (DB+), R38.2, R39.2
GND_ISO1: C1.2, C5.2, IC1.9 (GNDS_1), IC1.10 (NC_4), IC1.11 (NC_5), IC1.12 (NC_6), IC1.15 (GNDS_2), IC1.16 (GNDS_3), IC9.9 (GNDS_1), IC9.10 (NC_4), IC9.11 (NC_5), IC9.12 (NC_6), IC9.15 (GNDS_2), IC9.16 (GNDS_3), J3.2, J3.10
GND_ISO2: C2.2, C6.2, IC2.9 (GNDS_1), IC2.10 (NC_4), IC2.11 (NC_5), IC2.12 (NC_6), IC2.15 (GNDS_2), IC2.16 (GNDS_3), IC10.9 (GNDS_1), IC10.10 (NC_4), IC10.11 (NC_5), IC10.12 (NC_6), IC10.15 (GNDS_2), IC10.16 (GNDS_3), J3.4, J3.12
GND_ISO3: C3.2, C7.2, IC3.9 (GNDS_1), IC3.10 (NC_4), IC3.11 (NC_5), IC3.12 (NC_6), IC3.15 (GNDS_2), IC3.16 (GNDS_3), IC11.9 (GNDS_1), IC11.10 (NC_4), IC11.11 (NC_5), IC11.12 (NC_6), IC11.15 (GNDS_2), IC11.16 (GNDS_3), J3.6, J3.14
GND_ISO4: C4.2, C8.2, IC4.9 (GNDS_1), IC4.10 (NC_4), IC4.11 (NC_5), IC4.12 (NC_6), IC4.15 (GNDS_2), IC4.16 (GNDS_3), IC12.9 (GNDS_1), IC12.10 (NC_4), IC12.11 (NC_5), IC12.12 (NC_6), IC12.15 (GNDS_2), IC12.16 (GNDS_3), J3.8, J3.16
GND_ISO5: C28.2, C32.2, IC8.9 (GNDS_1), IC8.10 (NC_4), IC8.11 (NC_5), IC8.12 (NC_6), IC8.15 (GNDS_2), IC8.16 (GNDS_3), IC15.9 (GNDS_1), IC15.10 (NC_4), IC15.11 (NC_5), IC15.12 (NC_6), IC15.15 (GNDS_2), IC15.16 (GNDS_3), J4.8, J4.16
GND_ISO6: C27.2, C31.2, IC7.9 (GNDS_1), IC7.10 (NC_4), IC7.11 (NC_5), IC7.12 (NC_6), IC7.15 (GNDS_2), IC7.16 (GNDS_3), IC14.9 (GNDS_1), IC14.10 (NC_4), IC14.11 (NC_5), IC14.12 (NC_6), IC14.15 (GNDS_2), IC14.16 (GNDS_3), J4.6, J4.14
GND_ISO7: C26.2, C30.2, IC6.9 (GNDS_1), IC6.10 (NC_4), IC6.11 (NC_5), IC6.12 (NC_6), IC6.15 (GNDS_2), IC6.16 (GNDS_3), IC13.9 (GNDS_1), IC13.10 (NC_4), IC13.11 (NC_5), IC13.12 (NC_6), IC13.15 (GNDS_2), IC13.16 (GNDS_3), J4.4, J4.12
GND_ISO8: C25.2, C29.2, IC5.9 (GNDS_1), IC5.10 (NC_4), IC5.11 (NC_5), IC5.12 (NC_6), IC5.15 (GNDS_2), IC5.16 (GNDS_3), IC16.9 (GNDS_1), IC16.10 (NC_4), IC16.11 (NC_5), IC16.12 (NC_6), IC16.15 (GNDS_2), IC16.16 (GNDS_3), J4.2, J4.10
unnamed: IC17.5 (ADJ), R41.1, R42.2
unnamed: C80.2, F1.1, IC17.4 (OUT)
unnamed: IC18.5 (ADJ), R44.1, R45.2
unnamed: C83.2, F2.1, IC18.4 (OUT)
unnamed: J1.A5 (CC1), R33.1
unnamed: J1.B5 (CC2), R40.2
unnamed: R42.1, R43.2
RESET: C79.1, C80.1, C81.1, C82.1, C83.1, C84.1, IC1.2 (GNDP), IC1.4 (SYNC), IC1.6 (NC_1), IC1.7 (NC_2), IC1.8 (NC_3), IC2.2 (GNDP), IC2.4 (SYNC), IC2.6 (NC_1), IC2.7 (NC_2), IC2.8 (NC_3), IC3.2 (GNDP), IC3.4 (SYNC), IC3.6 (NC_1), IC3.7 (NC_2), IC3.8 (NC_3), IC4.2 (GNDP), IC4.4 (SYNC), IC4.6 (NC_1), IC4.7 (NC_2), IC4.8 (NC_3), IC5.2 (GNDP), IC5.4 (SYNC), IC5.6 (NC_1), IC5.7 (NC_2), IC5.8 (NC_3), IC6.2 (GNDP), IC6.4 (SYNC), IC6.6 (NC_1), IC6.7 (NC_2), IC6.8 (NC_3), IC7.2 (GNDP), IC7.4 (SYNC), IC7.6 (NC_1), IC7.7 (NC_2), IC7.8 (NC_3), IC8.2 (GNDP), IC8.4 (SYNC), IC8.6 (NC_1), IC8.7 (NC_2), IC8.8 (NC_3), IC9.2 (GNDP), IC9.4 (SYNC), IC9.6 (NC_1), IC9.7 (NC_2), IC9.8 (NC_3), IC10.2 (GNDP), IC10.4 (SYNC), IC10.6 (NC_1), IC10.7 (NC_2), IC10.8 (NC_3), IC11.2 (GNDP), IC11.4 (SYNC), IC11.6 (NC_1), IC11.7 (NC_2), IC11.8 (NC_3), IC12.2 (GNDP), IC12.4 (SYNC), IC12.6 (NC_1), IC12.7 (NC_2), IC12.8 (NC_3), IC13.2 (GNDP), IC13.4 (SYNC), IC13.6 (NC_1), IC13.7 (NC_2), IC13.8 (NC_3), IC14.2 (GNDP), IC14.4 (SYNC), IC14.6 (NC_1), IC14.7 (NC_2), IC14.8 (NC_3), IC15.2 (GNDP), IC15.4 (SYNC), IC15.6 (NC_1), IC15.7 (NC_2), IC15.8 (NC_3), IC16.2 (GNDP), IC16.4 (SYNC), IC16.6 (NC_1), IC16.7 (NC_2), IC16.8 (NC_3), IC17.3 (GND_1), IC17.6 (GND_2), IC18.3 (GND_1), IC18.6 (GND_2), J1.A1 (GND1), J1.A12 (GND2), J1.B1 (GND3), J1.B12 (GND4), J1.SH1 (SHIELD1), J1.SH2 (SHIELD2), J1.SH3 (SHIELD3), J1.SH4 (SHIELD4), J5.1, J5.2, J5.3, J5.4, J6.1, J6.3, R33.2, R40.1, R43.1, R45.1, U1.2 (GND1), U1.8 (GND1), U1.9 (GND2), U1.15 (GND2), U2.7 (NRST), U2.8 (VSSA), U2.23 (VSS), U2.35 (VSS), U2.47 (VSS)
RS485-A: J6.4, U1.12 (A)
RS485-B: J6.2, U1.13 (B)
RS485-DIR: U1.4 (~RE), U1.5 (DE), U2.2 (PC13)
RS485-RX: U1.3 (RxD), U2.43 (PB7)
RS485-TX: U1.6 (TxD), U2.42 (PB6)
USB_DM: R37.2, U2.32 (PA11)
USB_DP: R38.1, U2.33 (PA12)
VBAT: C79.2, F1.2, R39.1, U1.1 (VDD1), U1.7 (PV), U2.1 (VBAT), U2.9 (VDDA), U2.24 (VDD), U2.36 (VDD), U2.48 (VDD)
