usern4mehere9/LVPSU/LV_Regulator/LV_Regulator/LV_Regulator.kicad_pcb

## KiCad design LV_Regulator/LV_Regulator/LV_Regulator.kicad_pcb (2026-06-02)

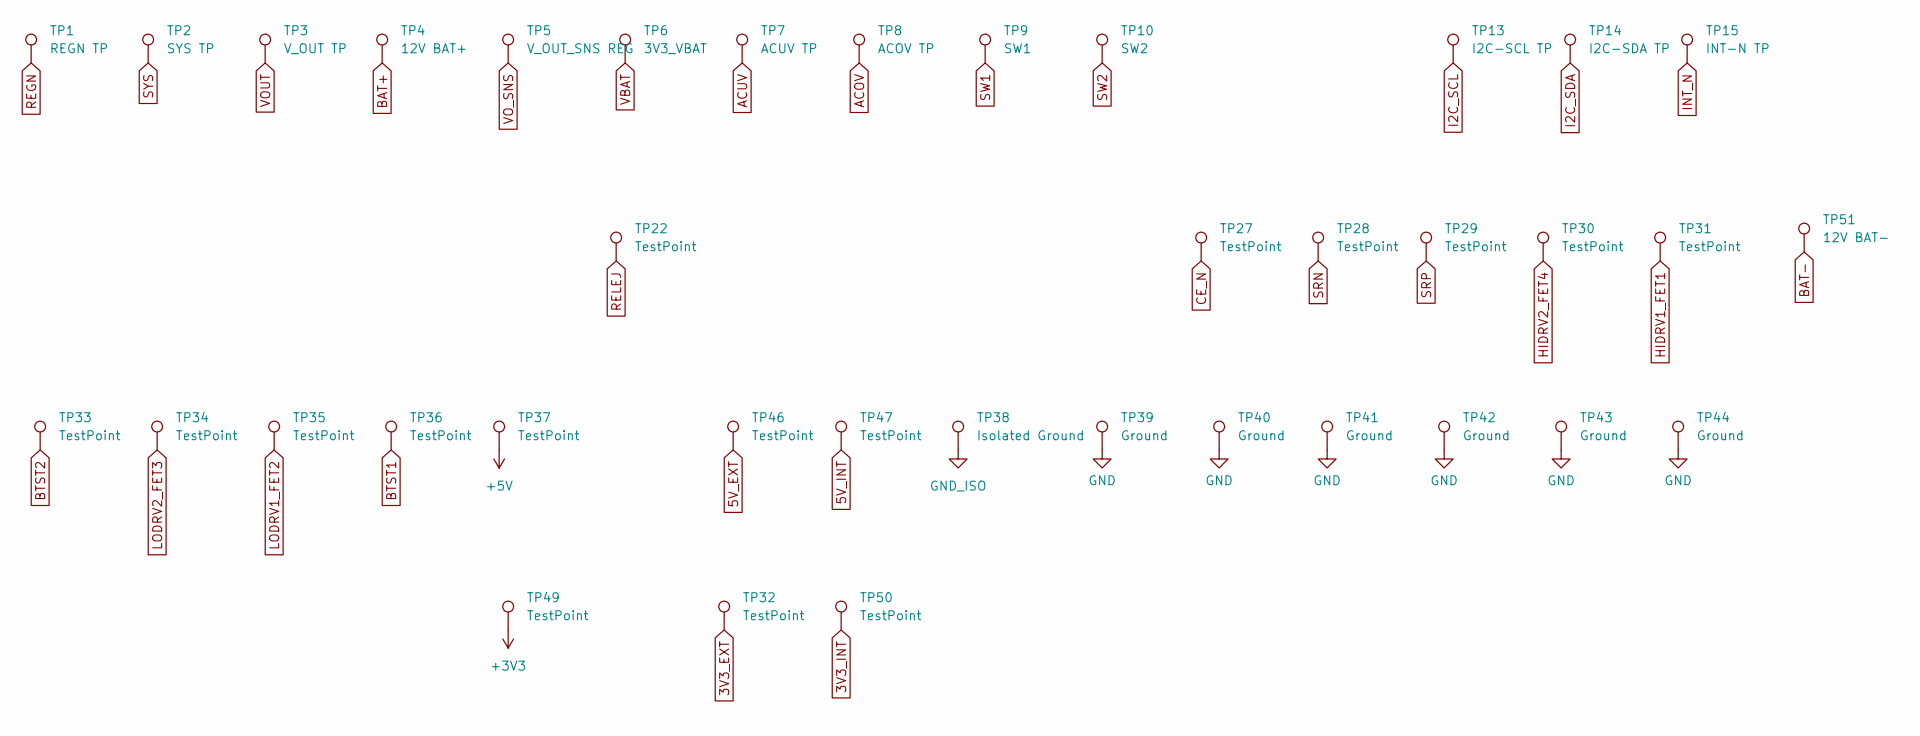
[picture p83: schematic test_points.kicad_sch]

Parts:
TP1: REGN TP; TestPoint_Pad_1.0x1.0mm
TP2: SYS TP; TestPoint_Pad_1.0x1.0mm
TP3: V_OUT TP; TestPoint_Pad_1.0x1.0mm
TP4: 12V BAT+; TestPoint_Pad_1.0x1.0mm
TP5: V_OUT_SNS REG; TestPoint_Pad_1.0x1.0mm
TP6: 3V3_VBAT; TestPoint_Pad_1.0x1.0mm
TP7: ACUV TP; TestPoint_Pad_1.0x1.0mm
TP8: ACOV TP; TestPoint_Pad_1.0x1.0mm
TP9: SW1; TestPoint_Pad_1.0x1.0mm
TP10: SW2; TestPoint_Pad_1.0x1.0mm
TP13: I2C-SCL TP; TestPoint_Pad_1.0x1.0mm
TP14: I2C-SDA TP; TestPoint_Pad_1.0x1.0mm
TP15: INT-N TP; TestPoint_Pad_1.0x1.0mm
TP22, TP27, TP28, TP29, TP30, TP31, TP32, TP33, TP34, TP35, TP36, TP37, TP46, TP47, TP49, TP50: TestPoint; TestPoint_Pad_1.0x1.0mm
TP38: Isolated Ground; TestPoint_Pad_1.0x1.0mm
TP39, TP40, TP41, TP42, TP43, TP44: Ground; TestPoint_Pad_1.0x1.0mm
TP51: 12V BAT-; TestPoint_Pad_1.0x1.0mm

Connections:
3V3_EXT: TP32.1 (1_1); also elsewhere on the board
3V3_INT: TP50.1 (1_1); also elsewhere on the board
5V_EXT: TP46.1 (1_1); also elsewhere on the board
5V_INT: TP47.1 (1_1); also elsewhere on the board
+5V: TP37.1 (1_1); also elsewhere on the board
ACOV: TP8.1 (1_1); also elsewhere on the board
ACUV: TP7.1 (1_1); also elsewhere on the board
BAT+: TP4.1 (1_1); also elsewhere on the board
BAT-: TP51.1 (1_1); also elsewhere on the board
BTST1: TP36.1 (1_1); also elsewhere on the board
BTST2: TP33.1 (1_1); also elsewhere on the board
CE_N: TP27.1 (1_1); also elsewhere on the board
GND: TP39.1 (1_1), TP40.1 (1_1), TP41.1 (1_1), TP42.1 (1_1), TP43.1 (1_1), TP44.1 (1_1); also elsewhere on the board
GND_ISO: TP38.1 (1_1); also elsewhere on the board
HIDRV1_FET1: TP31.1 (1_1); also elsewhere on the board
HIDRV2_FET4: TP30.1 (1_1); also elsewhere on the board
I2C_SCL: TP13.1 (1_1); also elsewhere on the board
I2C_SDA: TP14.1 (1_1); also elsewhere on the board
INT_N: TP15.1 (1_1); also elsewhere on the board
LODRV1_FET2: TP35.1 (1_1); also elsewhere on the board
LODRV2_FET3: TP34.1 (1_1); also elsewhere on the board
REGN: TP1.1 (1_1); also elsewhere on the board
RELEJ: TP22.1 (1_1); also elsewhere on the board
SRN: TP28.1 (1_1); also elsewhere on the board
SRP: TP29.1 (1_1); also elsewhere on the board
SW1: TP9.1 (1_1); also elsewhere on the board
SW2: TP10.1 (1_1); also elsewhere on the board
SYS: TP2.1 (1_1); also elsewhere on the board
VBAT: TP6.1 (1_1), TP49.1 (1_1); also elsewhere on the board
VOUT: TP3.1 (1_1), TP5.1 (1_1); also elsewhere on the board

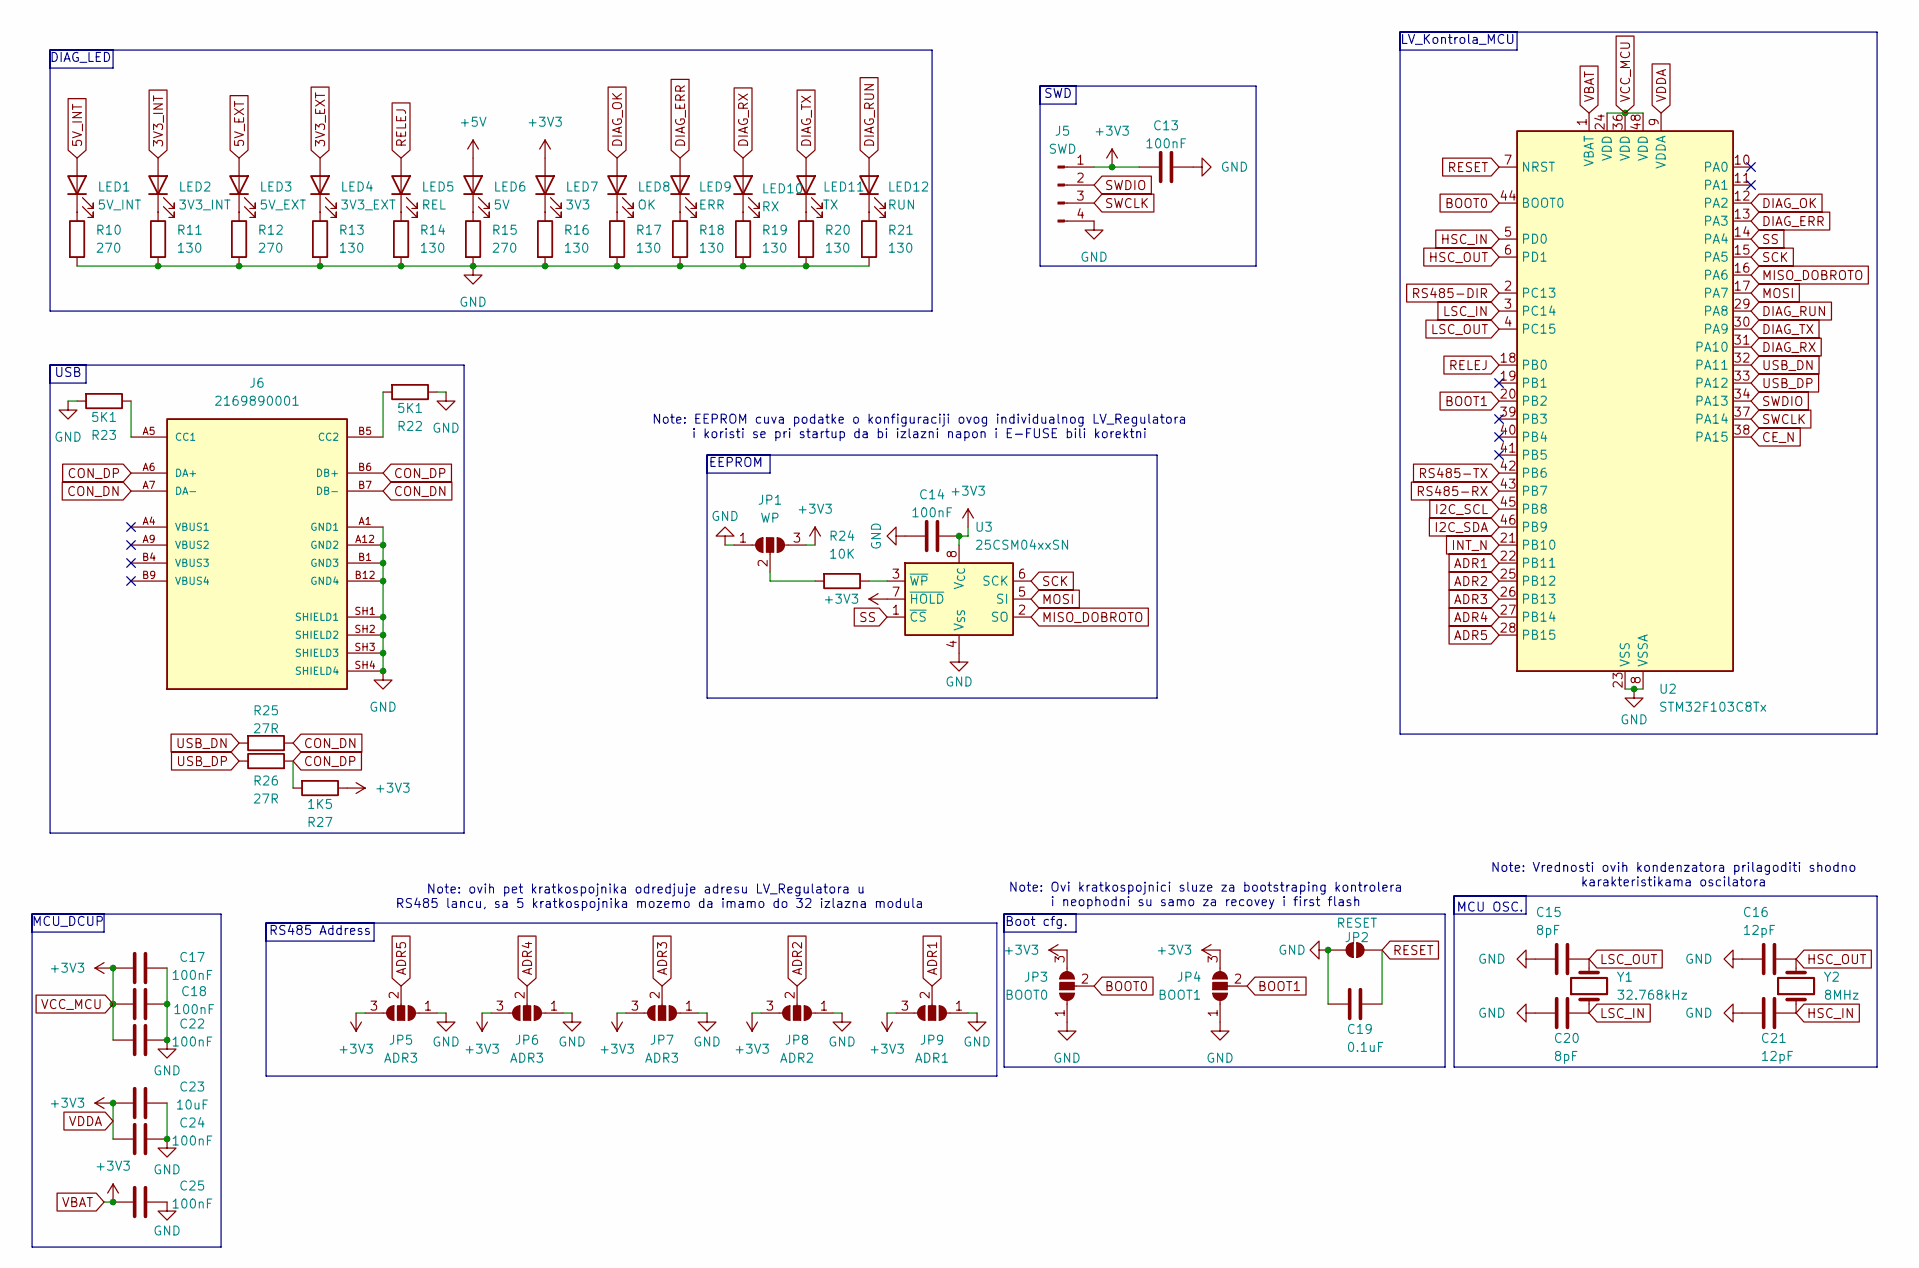
[picture p84: schematic mcu.kicad_sch, LV_Regulator_Main]

Parts:
C13, C14, C17, C18, C22, C24, C25: 100nF; C_1206_3216Metric_Pad1.33x1.80mm_HandSolder
C15, C20: 8pF; C_1206_3216Metric_Pad1.33x1.80mm_HandSolder
C16, C21: 12pF; C_1206_3216Metric_Pad1.33x1.80mm_HandSolder
C19: 0.1uF; C_1206_3216Metric_Pad1.33x1.80mm_HandSolder
C23: 10uF; C_1206_3216Metric_Pad1.33x1.80mm_HandSolder
J5: SWD; PinHeader_1x04_P2.54mm_Vertical
J6: 2169890001; MOLEX_2169890001; PARTREV B
JP1: WP; SolderJumper-3_P1.3mm_Open_RoundedPad1.0x1.5mm
JP2: RESET; SolderJumper-2_P1.3mm_Open_RoundedPad1.0x1.5mm
JP3: BOOT0; SolderJumper-3_P1.3mm_Open_RoundedPad1.0x1.5mm
JP4: BOOT1; SolderJumper-3_P1.3mm_Open_RoundedPad1.0x1.5mm
JP5, JP6, JP7: ADR3; SolderJumper-3_P1.3mm_Open_RoundedPad1.0x1.5mm
JP8: ADR2; SolderJumper-3_P1.3mm_Open_RoundedPad1.0x1.5mm
JP9: ADR1; SolderJumper-3_P1.3mm_Open_RoundedPad1.0x1.5mm
LED1: 5V_INT; LED_1206_3216Metric_Pad1.42x1.75mm_HandSolder
LED2: 3V3_INT; LED_1206_3216Metric_Pad1.42x1.75mm_HandSolder
LED3: 5V_EXT; LED_1206_3216Metric_Pad1.42x1.75mm_HandSolder
LED4: 3V3_EXT; LED_1206_3216Metric_Pad1.42x1.75mm_HandSolder
LED5: REL; LED_1206_3216Metric_Pad1.42x1.75mm_HandSolder
LED6: 5V; LED_1206_3216Metric_Pad1.42x1.75mm_HandSolder
LED7: 3V3; LED_1206_3216Metric_Pad1.42x1.75mm_HandSolder
LED8: OK; LED_1206_3216Metric_Pad1.42x1.75mm_HandSolder
LED9: ERR; LED_1206_3216Metric_Pad1.42x1.75mm_HandSolder
LED10: RX; LED_1206_3216Metric_Pad1.42x1.75mm_HandSolder
LED11: TX; LED_1206_3216Metric_Pad1.42x1.75mm_HandSolder
LED12: RUN; LED_1206_3216Metric_Pad1.42x1.75mm_HandSolder
R10, R12, R15: 270; R_1206_3216Metric_Pad1.30x1.75mm_HandSolder
R11, R13, R14, R16, R17, R18, R19, R20, R21: 130; R_1206_3216Metric_Pad1.30x1.75mm_HandSolder
R22, R23: 5K1; R_1206_3216Metric_Pad1.30x1.75mm_HandSolder
R24: 10K; R_1206_3216Metric_Pad1.30x1.75mm_HandSolder
R25, R26: 27R; R_1206_3216Metric_Pad1.30x1.75mm_HandSolder
R27: 1K5; R_1206_3216Metric_Pad1.30x1.75mm_HandSolder
U2: STM32F103C8Tx; LQFP-48_7x7mm_P0.5mm
U3: 25CSM04xxSN; SOIC-8_3.9x4.9mm_P1.27mm
Y1: 32.768kHz; Crystal_SMD_EuroQuartz_EQ161-2Pin_3.2x1.5mm_HandSoldering
Y2: 8MHz; Crystal_SMD_5032-2Pin_5.0x3.2mm_HandSoldering

Connections:
3V3_EXT: LED4.2 (A); also elsewhere on the board
3V3_INT: LED2.2 (A); also elsewhere on the board
5V_EXT: LED3.2 (A); also elsewhere on the board
5V_INT: LED1.2 (A); also elsewhere on the board
+5V: LED6.2 (A); also elsewhere on the board
ADR1: JP9.2 (C), U2.22 (PB11)
ADR2: JP8.2 (C), U2.25 (PB12)
ADR3: JP7.2 (C), U2.26 (PB13)
ADR4: JP6.2 (C), U2.27 (PB14)
ADR5: JP5.2 (C), U2.28 (PB15)
BOOT0: JP3.2 (C), U2.44 (BOOT0)
BOOT1: JP4.2 (C), U2.20 (PB2)
CE_N: U2.38 (PA15); also elsewhere on the board
CON_DN: J6.A7 (DA-), J6.B7 (DB-), R25.1
CON_DP: J6.A6 (DA+), J6.B6 (DB+), R26.2, R27.2
DIAG_ERR: LED9.2 (A), U2.13 (PA3)
DIAG_OK: LED8.2 (A), U2.12 (PA2)
DIAG_RUN: LED12.2 (A), U2.29 (PA8)
DIAG_RX: LED10.2 (A), U2.31 (PA10)
DIAG_TX: LED11.2 (A), U2.30 (PA9)
GND: C13.1, C14.2, C15.1, C16.1, C17.2, C18.2, C19.2, C20.2, C21.2, C22.2, C23.2, C24.2, C25.2, J5.4, J6.A1 (GND1), J6.A12 (GND2), J6.B1 (GND3), J6.B12 (GND4), J6.SH1 (SHIELD1), J6.SH2 (SHIELD2), J6.SH3 (SHIELD3), J6.SH4 (SHIELD4), JP1.1 (A), JP2.1 (A), JP3.1 (A), JP4.1 (A), JP5.1 (A), JP6.1 (A), JP7.1 (A), JP8.1 (A), JP9.1 (A), R10.2, R11.2, R12.2, R13.2, R14.2, R15.2, R16.2, R17.2, R18.2, R19.2, R20.2, R21.2, R22.1, R23.2, U2.8 (VSSA), U2.23 (VSS), U2.35 (VSS), U2.47 (VSS), U3.4 (V_{SS}); also elsewhere on the board
HSC_IN: C21.1, U2.5 (PD0), Y2.1
HSC_OUT: C16.2, U2.6 (PD1), Y2.2
I2C_SCL: U2.45 (PB8); also elsewhere on the board
I2C_SDA: U2.46 (PB9); also elsewhere on the board
INT_N: U2.21 (PB10); also elsewhere on the board
LSC_IN: C20.1, U2.3 (PC14), Y1.1
LSC_OUT: C15.2, U2.4 (PC15), Y1.2
MISO_DOBROTO: U2.16 (PA6), U3.2 (SO)
MOSI: U2.17 (PA7), U3.5 (SI)
unnamed: J6.A5 (CC1), R23.1
unnamed: J6.B5 (CC2), R22.2
unnamed: JP1.2 (C), R24.2
unnamed: LED1.1 (K), R10.1
unnamed: LED2.1 (K), R11.1
unnamed: LED3.1 (K), R12.1
unnamed: LED4.1 (K), R13.1
unnamed: LED5.1 (K), R14.1
unnamed: LED6.1 (K), R15.1
unnamed: LED7.1 (K), R16.1
unnamed: LED8.1 (K), R17.1
unnamed: LED9.1 (K), R18.1
unnamed: LED10.1 (K), R19.1
unnamed: LED11.1 (K), R20.1
unnamed: LED12.1 (K), R21.1
unnamed: R24.1, U3.3 (~WP)
RELEJ: LED5.2 (A), U2.18 (PB0); also elsewhere on the board
RESET: C19.1, JP2.2 (B), U2.7 (NRST)
RS485-DIR: U2.2 (PC13); also elsewhere on the board
RS485-RX: U2.43 (PB7); also elsewhere on the board
RS485-TX: U2.42 (PB6); also elsewhere on the board
SCK: U2.15 (PA5), U3.6 (SCK)
SS: U2.14 (PA4), U3.1 (~CS)
SWCLK: J5.3, U2.37 (PA14)
SWDIO: J5.2, U2.34 (PA13)
USB_DN: R25.2, U2.32 (PA11)
USB_DP: R26.1, U2.33 (PA12)
VBAT: C13.2, C14.1, C17.1, C18.1, C22.1, C23.1, C24.1, C25.1, J5.1, JP1.3 (B), JP3.3 (B), JP4.3 (B), JP5.3 (B), JP6.3 (B), JP7.3 (B), JP8.3 (B), JP9.3 (B), LED7.2 (A), R27.1, U2.1 (VBAT), U2.9 (VDDA), U2.24 (VDD), U2.36 (VDD), U2.48 (VDD), U3.7 (~HOLD), U3.8 (V_{CC}); also elsewhere on the board

Notes on the sheet:
RS485 Address
MCU_DCUP
EEPROM
LV_Kontrola_MCU
Note: Ovi kratkospojnici sluze za bootstraping kontrolera i neophodni su samo za recovey i first flash
USB
Boot cfg.
Note: Vrednosti ovih kondenzatora prilagoditi shodno karakteristikama oscilatora
Note: ovih pet kratkospojnika odredjuje adresu LV_Regulatora u RS485 lancu, sa 5 kratkospojnika mozemo da imamo do 32 izlazna modula
Note: EEPROM cuva podatke o konfiguraciji ovog individualnog LV_Regulatora i koristi se pri startup da bi izlazni napon i E-FUSE bili korektni
MCU OSC.
SWD
DIAG_LED

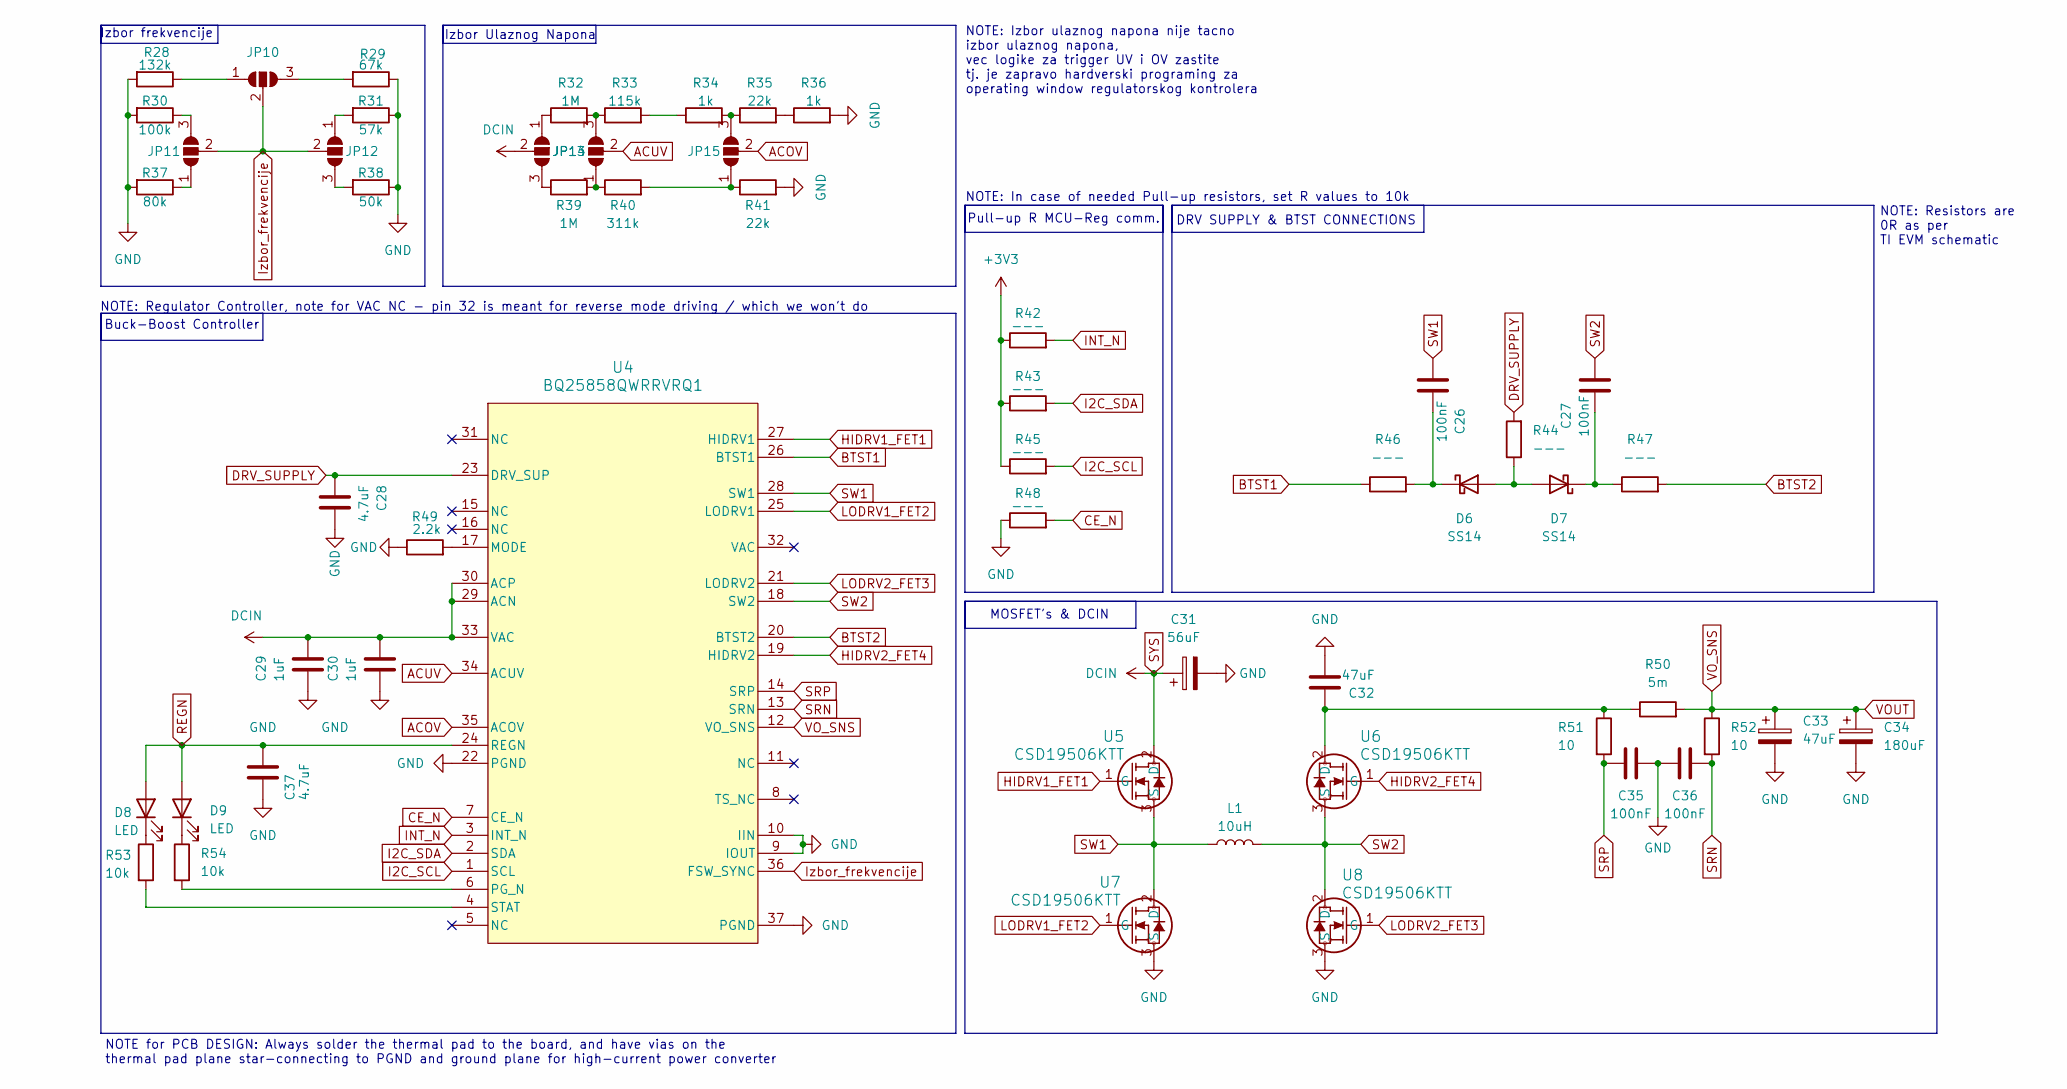
[picture p85: schematic regulator.kicad_sch, LV_Regulator_Main]

Parts:
C26, C27, C35, C36: 100nF; C_1206_3216Metric
C28, C37: 4.7uF; C_1206_3216Metric
C29, C30: 1uF; C_1206_3216Metric
C31: 56uF; CP_Elec_10x10
C32, C33: 47uF; CP_Elec_10x10
C34: 180uF; CAP_UCD_12P5X13P5_NCH
D6, D7: SS14; CR_SMA_403AE_OSI
D8, D9: LED; D_1206_3216Metric_Pad1.42x1.75mm_HandSolder
JP10, JP11, JP12, JP13, JP14, JP15: SolderJumper_3_Open; SolderJumper-3_P1.3mm_Open_RoundedPad1.0x1.5mm
L1: 10uH; L_APV_APH1770
R28: 132k; R_1206_3216Metric_Pad1.30x1.75mm_HandSolder
R29: 67k; R_1206_3216Metric_Pad1.30x1.75mm_HandSolder
R30: 100k; R_1206_3216Metric_Pad1.30x1.75mm_HandSolder
R31: 57k; R_1206_3216Metric_Pad1.30x1.75mm_HandSolder
R32, R39: 1M; R_1206_3216Metric_Pad1.30x1.75mm_HandSolder
R33: 115k; R_1206_3216Metric_Pad1.30x1.75mm_HandSolder
R34, R36: 1k; R_1206_3216Metric_Pad1.30x1.75mm_HandSolder
R35, R41: 22k; R_1206_3216Metric_Pad1.30x1.75mm_HandSolder
R37: 80k; R_1206_3216Metric_Pad1.30x1.75mm_HandSolder
R38: 50k; R_1206_3216Metric_Pad1.30x1.75mm_HandSolder
R40: 311k; R_1206_3216Metric_Pad1.30x1.75mm_HandSolder
R42, R43, R44, R45, R46, R47, R48: ---; R_1206_3216Metric_Pad1.30x1.75mm_HandSolder
R49: 2.2k; R_1206_3216Metric_Pad1.30x1.75mm_HandSolder
R50: 5m; RESC50110X70N
R51, R52: 10; R_1206_3216Metric_Pad1.30x1.75mm_HandSolder
R53, R54: 10k; R_1206_3216Metric_Pad1.30x1.75mm_HandSolder
U4: BQ25858QWRRVRQ1; RRV0036B-IPC_A
U5, U6, U7, U8: CSD19506KTT; DDPAK&slash_TO-263_KTT_TEX

Connections:
ACOV: JP15.2 (C), U4.35 (ACOV); also elsewhere on the board
ACUV: JP14.2 (C), U4.34 (ACUV); also elsewhere on the board
BTST1: R46.1, U4.26 (BTST1); also elsewhere on the board
BTST2: R47.2, U4.20 (BTST2); also elsewhere on the board
CE_N: R48.2, U4.7 (CE_N); also elsewhere on the board
DRV_SUPPLY: C28.1, R44.2, U4.23 (DRV_SUP)
GND: C28.2, C29.1, C30.1, C31.2, C32.2, C33.2, C34.2, C35.2, C36.1, C37.1, R28.2, R29.1, R30.2, R31.1, R36.2, R37.2, R38.1, R41.2, R48.1, R49.1, U4.9 (IOUT), U4.10 (IIN), U4.22 (PGND), U4.37 (PGND), U7.3 (S), U8.3 (S); also elsewhere on the board
HIDRV1_FET1: U4.27 (HIDRV1), U5.1 (G); also elsewhere on the board
HIDRV2_FET4: U4.19 (HIDRV2), U6.1 (G); also elsewhere on the board
I2C_SCL: R45.2, U4.1 (SCL); also elsewhere on the board
I2C_SDA: R43.2, U4.2 (SDA); also elsewhere on the board
INT_N: R42.2, U4.3 (INT_N); also elsewhere on the board
Izbor_frekvencije: JP10.2 (C), JP11.2 (C), JP12.2 (C), U4.36 (FSW_SYNC)
LODRV1_FET2: U4.25 (LODRV1), U7.1 (G); also elsewhere on the board
LODRV2_FET3: U4.21 (LODRV2), U8.1 (G); also elsewhere on the board
unnamed: D6.2 (A), D7.2 (A), R44.1
unnamed: C26.2, D6.1 (K), R46.2
unnamed: C27.2, D7.1 (K), R47.1
unnamed: D8.1 (K), R53.1
unnamed: D9.1 (K), R54.1
unnamed: JP10.1 (A), R28.1
unnamed: JP10.3 (B), R29.2
unnamed: JP11.1 (A), R37.1
unnamed: JP11.3 (B), R30.1
unnamed: JP12.1 (A), R31.2
unnamed: JP12.3 (B), R38.2
unnamed: JP13.1 (A), R32.1
unnamed: JP13.3 (B), R39.1
unnamed: JP14.1 (A), R39.2, R40.1
unnamed: JP14.3 (B), R32.2, R33.1
unnamed: JP15.1 (A), R40.2, R41.1
unnamed: JP15.3 (B), R34.2, R35.1
unnamed: R33.2, R34.1
unnamed: R35.2, R36.1
unnamed: R49.2, U4.17 (MODE)
unnamed: R54.2, U4.6 (PG_N)
unnamed: R53.2, U4.4 (STAT)
unnamed: C32.1, R50.1, R51.1, U6.2 (D)
REGN: C37.2, D8.2 (A), D9.2 (A), U4.24 (REGN); also elsewhere on the board
SRN: C36.2, R52.2, U4.13 (SRN); also elsewhere on the board
SRP: C35.1, R51.2, U4.14 (SRP); also elsewhere on the board
SW1: C26.1, L1.1, U4.28 (SW1), U5.3 (S), U7.2 (D); also elsewhere on the board
SW2: C27.1, L1.2, U4.18 (SW2), U6.3 (S), U8.2 (D); also elsewhere on the board
SYS: C29.2, C30.2, C31.1, JP13.2 (C), U4.29 (ACN), U4.30 (ACP), U4.33 (VAC), U5.2 (D); also elsewhere on the board
VBAT: R42.1, R43.1, R45.1; also elsewhere on the board
VOUT: C33.1, C34.1, R50.2, R52.1, U4.12 (VO_SNS); also elsewhere on the board

Notes on the sheet:
Buck-Boost Controller
NOTE: Resistors are 0R as per TI EVM schematic
MOSFET's & DCIN
Pull-up R MCU-Reg comm.
Izbor Ulaznog Napona
NOTE: In case of needed Pull-up resistors, set R values to 10k
DRV SUPPLY & BTST CONNECTIONS
NOTE: Izbor ulaznog napona nije tacno izbor ulaznog napona, vec logike za trigger UV i OV zastite tj. je zapravo hardverski programing za operating window regulatorskog kontrolera
Izbor frekvencije
NOTE: Regulator Controller, note for VAC NC - pin 32 is meant for reverse mode driving / which we won't do
NOTE for PCB DESIGN: Always solder the thermal pad to the board, and have vias on the thermal pad plane star-connecting to PGND and ground plane for high-current power converter

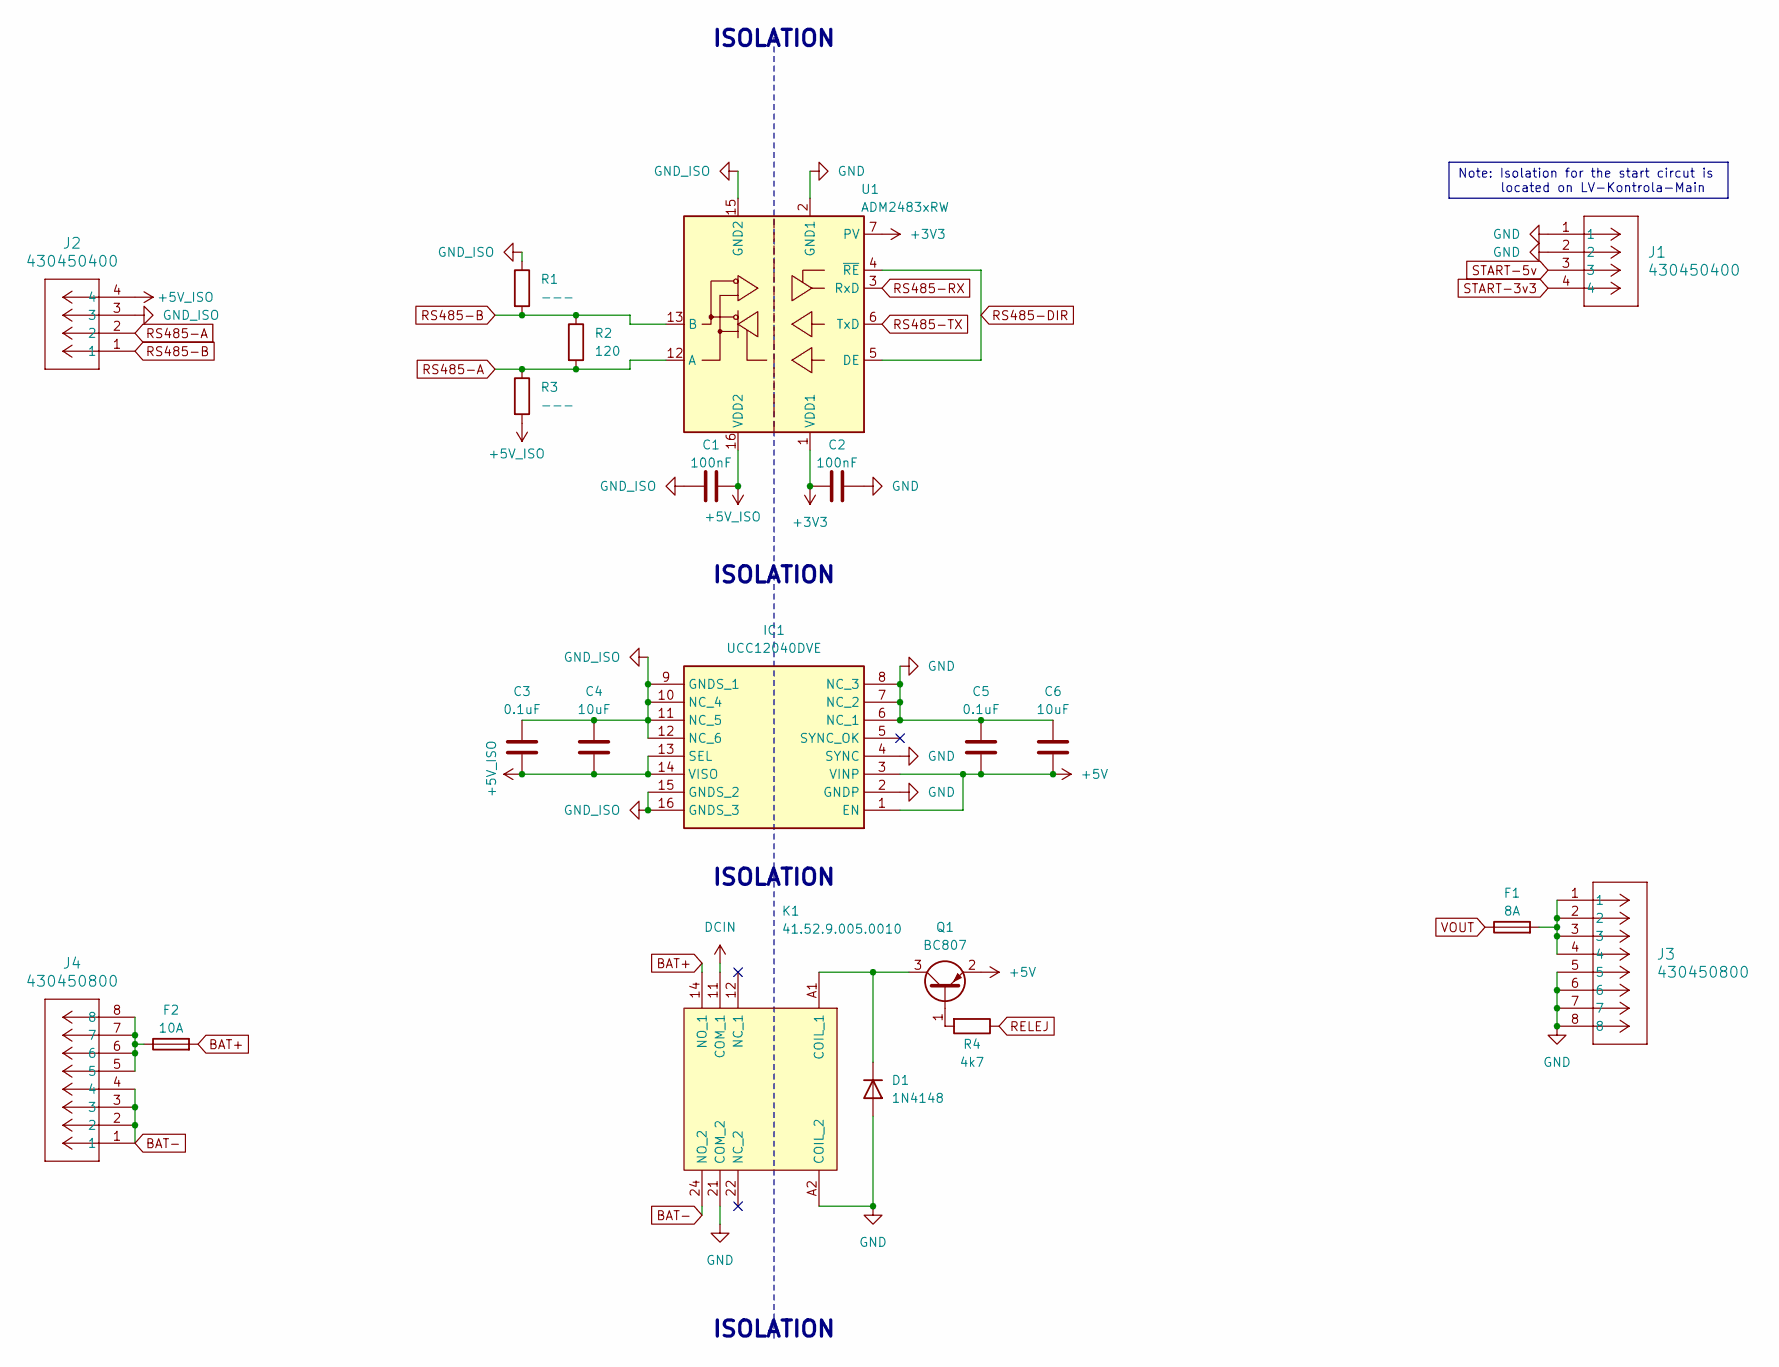
[picture p86: schematic isolation.kicad_sch, LV_Regulator_Main]

Parts:
C1, C2: 100nF; C_1206_3216Metric_Pad1.33x1.80mm_HandSolder
C3, C5: 0.1uF; C_1206_3216Metric_Pad1.33x1.80mm_HandSolder
C4, C6: 10uF; C_1206_3216Metric_Pad1.33x1.80mm_HandSolder
D1: 1N4148; D_1206_3216Metric_Pad1.42x1.75mm_HandSolder
F1: 8A; Fuse_1206_3216Metric_Pad1.42x1.75mm_HandSolder
F2: 10A; Fuse_1206_3216Metric_Pad1.42x1.75mm_HandSolder
IC1: UCC12040DVE; SOIC127P1030X265-16N; Mouser Part Number 595-UCC12040DVE
J1, J2: 430450400; CONN_SD-43045-001_04_MOL
J3, J4: 430450800; CONN_SD-43045-001_08_MOL
K1: 41.52.9.005.0010; 415290050010; Manufacturer_Part_Number 41.52.9.005.0010
Q1: BC807; SOT-23W_Handsoldering
R1, R3: ---; R_1206_3216Metric_Pad1.30x1.75mm_HandSolder
R2: 120; R_1206_3216Metric_Pad1.30x1.75mm_HandSolder
R4: 4k7; R_1206_3216Metric_Pad1.30x1.75mm_HandSolder
U1: ADM2483xRW; SOIC-16W_7.5x10.3mm_P1.27mm

Connections:
3V3_EXT: J1.4; also elsewhere on the board
5V_EXT: J1.3; also elsewhere on the board
+5V: C5.1, C6.1, IC1.1 (EN), IC1.3 (VINP), Q1.2 (E); also elsewhere on the board
+5V_ISO: C1.2, C3.1, C4.1, IC1.13 (SEL), IC1.14 (VISO), J2.4, R3.2, U1.16 (VDD2)
BAT+: F2.2, K1.14 (NO_1); also elsewhere on the board
BAT-: J4.1, J4.2, J4.3, J4.4, K1.24 (NO_2); also elsewhere on the board
GND: C2.2, C5.2, C6.2, D1.2 (A), IC1.2 (GNDP), IC1.4 (SYNC), IC1.6 (NC_1), IC1.7 (NC_2), IC1.8 (NC_3), J1.1, J1.2, J3.5, J3.6, J3.7, J3.8, K1.21 (COM_2), K1.A2 (COIL_2), U1.2 (GND1), U1.8 (GND1); also elsewhere on the board
GND_ISO: C1.1, C3.2, C4.2, IC1.9 (GNDS_1), IC1.10 (NC_4), IC1.11 (NC_5), IC1.12 (NC_6), IC1.15 (GNDS_2), IC1.16 (GNDS_3), J2.3, R1.1, U1.9 (GND2), U1.15 (GND2); also elsewhere on the board
unnamed: D1.1 (K), K1.A1 (COIL_1), Q1.3 (C)
unnamed: F1.2, J3.1, J3.2, J3.3, J3.4
unnamed: F2.1, J4.5, J4.6, J4.7, J4.8
unnamed: Q1.1 (B), R4.2
RELEJ: R4.1; also elsewhere on the board
RS485-A: J2.2, R2.2, R3.1, U1.12 (A)
RS485-B: J2.1, R1.2, R2.1, U1.13 (B)
RS485-DIR: U1.4 (~RE), U1.5 (DE); also elsewhere on the board
RS485-RX: U1.3 (RxD); also elsewhere on the board
RS485-TX: U1.6 (TxD); also elsewhere on the board
SYS: K1.11 (COM_1); also elsewhere on the board
VBAT: C2.1, U1.1 (VDD1), U1.7 (PV); also elsewhere on the board
VOUT: F1.1; also elsewhere on the board

Notes on the sheet:
ISOLATION
Note: Isolation for the start circut is located on LV-Kontrola-Main
