usern4mehere9/LVPSU/LV_Regulator/LV_Regulator/LV_Regulator.kicad_pcb

## KiCad design LV_Regulator/LV_Regulator/LV_Regulator.kicad_pcb (continued)

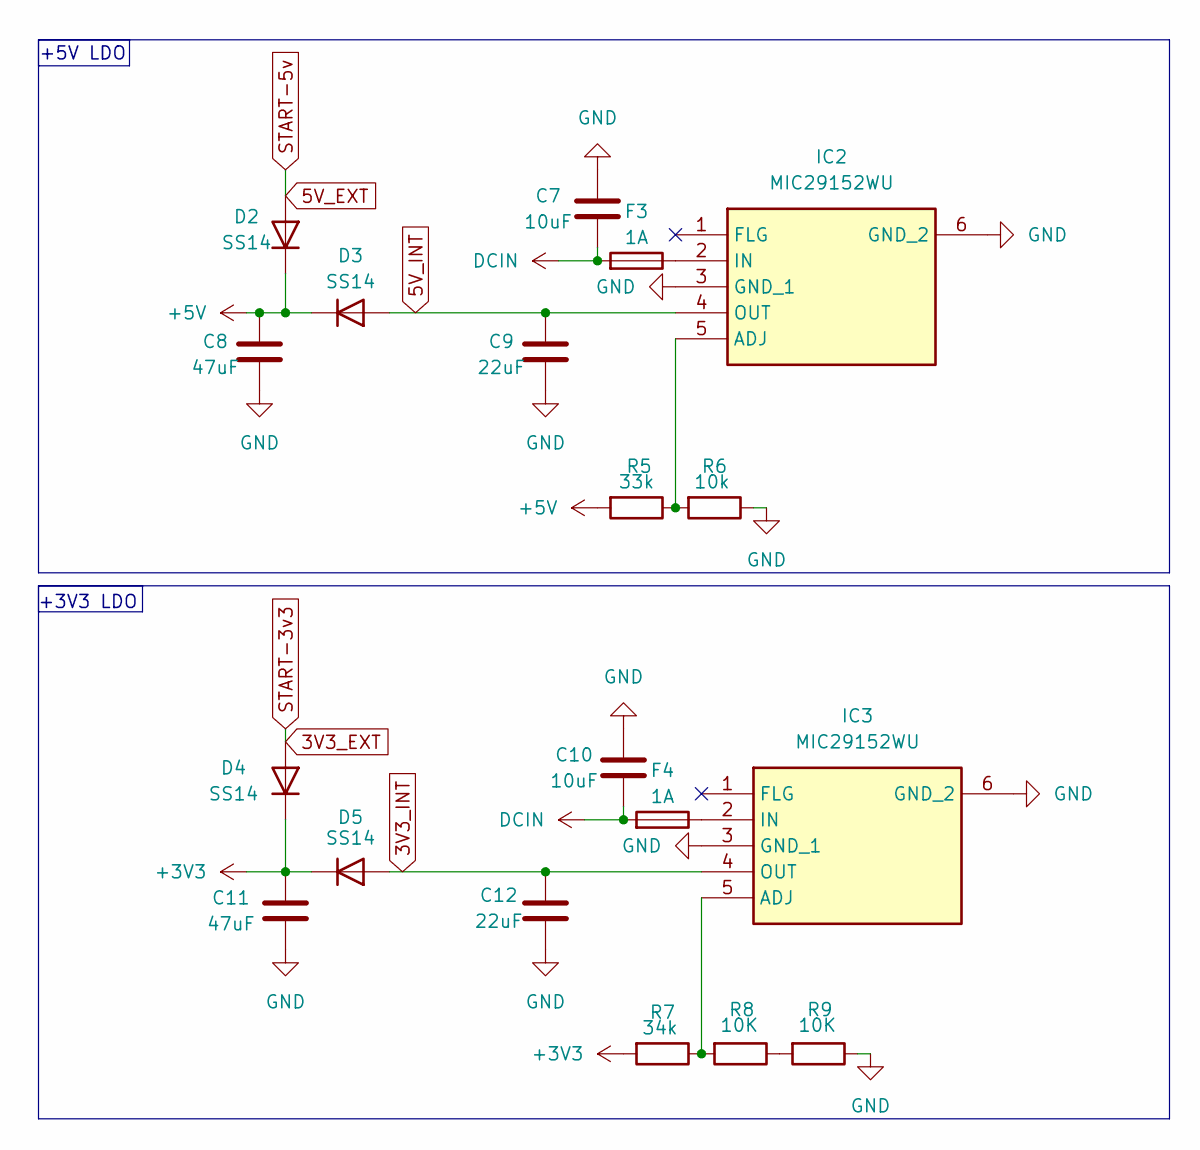
[picture p87: schematic logic_supply.kicad_sch, LV_Regulator_Main]

Parts:
C7, C10: 10uF; C_1206_3216Metric_Pad1.33x1.80mm_HandSolder
C8, C11: 47uF; C_1206_3216Metric_Pad1.33x1.80mm_HandSolder
C9, C12: 22uF; C_1206_3216Metric_Pad1.33x1.80mm_HandSolder
D2, D3, D4, D5: SS14; CR_SMA_403AE_OSI
F3, F4: 1A; Fuse_1206_3216Metric_Pad1.42x1.75mm_HandSolder
IC2, IC3: MIC29152WU; Mouser Part Number 998-MIC29152WU
R5: 33k; R_1206_3216Metric_Pad1.30x1.75mm_HandSolder
R6: 10k; R_1206_3216Metric_Pad1.30x1.75mm_HandSolder
R7: 34k; R_1206_3216Metric_Pad1.30x1.75mm_HandSolder
R8, R9: 10K; R_1206_3216Metric_Pad1.30x1.75mm_HandSolder

Connections:
3V3_EXT: D4.2 (A); also elsewhere on the board
3V3_INT: C12.2, D5.2 (A), IC3.4 (OUT); also elsewhere on the board
5V_EXT: D2.2 (A); also elsewhere on the board
5V_INT: C9.2, D3.2 (A), IC2.4 (OUT); also elsewhere on the board
+5V: C8.2, D2.1 (K), D3.1 (K), R5.2; also elsewhere on the board
GND: C7.1, C8.1, C9.1, C10.1, C11.1, C12.1, IC2.3 (GND_1), IC2.6 (GND_2), IC3.3 (GND_1), IC3.6 (GND_2), R6.1, R9.1; also elsewhere on the board
unnamed: IC2.5 (ADJ), R5.1, R6.2
unnamed: F3.1, IC2.2 (IN)
unnamed: IC3.5 (ADJ), R7.1, R8.2
unnamed: F4.1, IC3.2 (IN)
unnamed: R8.1, R9.2
SYS: C7.2, C10.2, F3.2, F4.2; also elsewhere on the board
VBAT: C11.2, D4.1 (K), D5.1 (K), R7.2; also elsewhere on the board

Notes on the sheet:
+5V LDO
+3V3 LDO

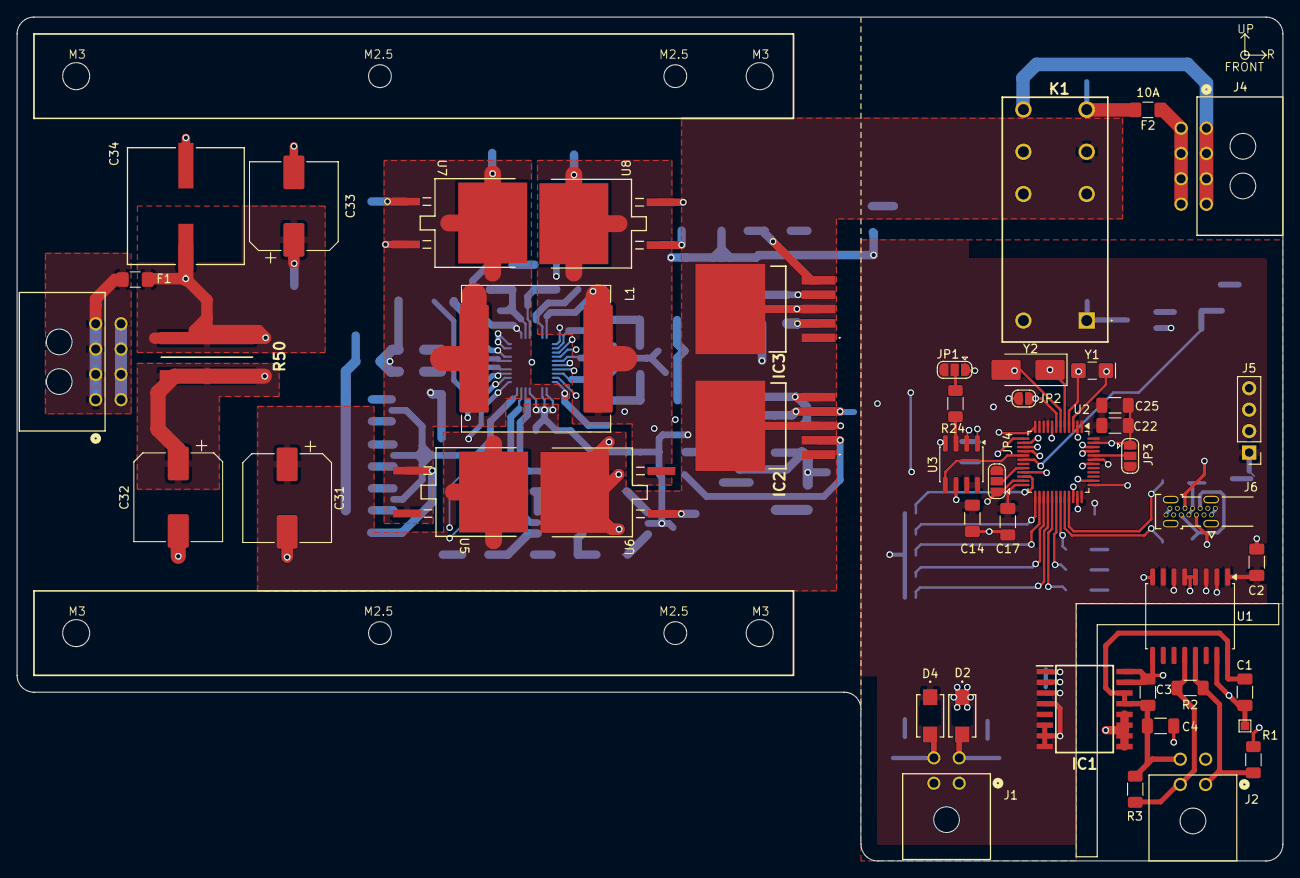
[picture p88: board LV_Regulator.kicad_pcb from above]

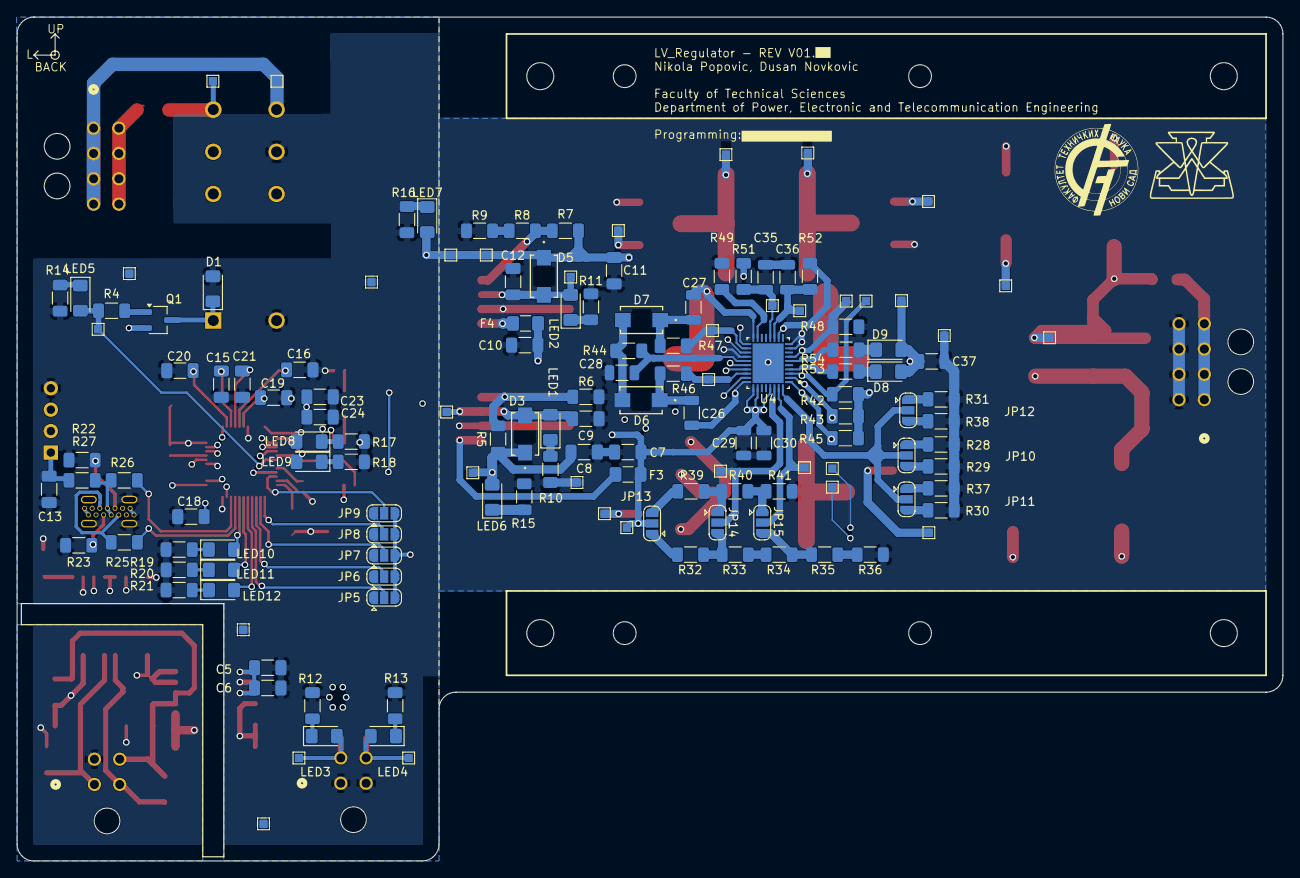
[picture p89: board LV_Regulator.kicad_pcb from below]

Board: 4 copper layers, 150.0 x 100.0 mm, 190 parts (144 on the bottom side), 113 nets.
