usern4mehere9/LVPSU/LV_Kontrola_Main/LV_Kontrola_Infeed_Bat/Code/LV_Kontrola_Main_Analogni/Core/Inc/main.h

#define Temperature_Cell1_Pin GPIO_PIN_6
#define Temperature_Cell1_GPIO_Port GPIOF
#define Temperature_Cell2_Pin GPIO_PIN_7
#define Temperature_Cell2_GPIO_Port GPIOF
#define Temperature_Cell3_Pin GPIO_PIN_8
#define Temperature_Cell3_GPIO_Port GPIOF
#define Temperature_Cell4_Pin GPIO_PIN_9
#define Temperature_Cell4_GPIO_Port GPIOF
#define Temperature_Cell5_Pin GPIO_PIN_10
#define Temperature_Cell5_GPIO_Port GPIOF
#define Temperature_Cell6_Pin GPIO_PIN_0
#define Temperature_Cell6_GPIO_Port GPIOC
#define Temperature_Cell7_Pin GPIO_PIN_1
#define Temperature_Cell7_GPIO_Port GPIOC
#define Voltage_Cell1_Pin GPIO_PIN_2
#define Voltage_Cell1_GPIO_Port GPIOC
#define Voltage_Cell2_Pin GPIO_PIN_3
#define Voltage_Cell2_GPIO_Port GPIOC
#define Voltage_Cell3_Pin GPIO_PIN_0
#define Voltage_Cell3_GPIO_Port GPIOA
#define Voltage_Cell4_Pin GPIO_PIN_1
#define Voltage_Cell4_GPIO_Port GPIOA
#define Voltage_Cell5_Pin GPIO_PIN_2
#define Voltage_Cell5_GPIO_Port GPIOA
#define Voltage_Cell6_Pin GPIO_PIN_3
#define Voltage_Cell6_GPIO_Port GPIOA
#define Voltage_Cell7_Pin GPIO_PIN_4
#define Voltage_Cell7_GPIO_Port GPIOA
#define Current_Cell1_Pin GPIO_PIN_5
#define Current_Cell1_GPIO_Port GPIOA
#define Current_Cell2_Pin GPIO_PIN_6
#define Current_Cell2_GPIO_Port GPIOA
#define Current_Cell3_Pin GPIO_PIN_7
#define Current_Cell3_GPIO_Port GPIOA
#define Current_Cell4_Pin GPIO_PIN_4
#define Current_Cell4_GPIO_Port GPIOC
#define Current_Cell5_Pin GPIO_PIN_5
#define Current_Cell5_GPIO_Port GPIOC
#define Current_Cell6_Pin GPIO_PIN_0
#define Current_Cell6_GPIO_Port GPIOB
#define Current_Cell7_Pin GPIO_PIN_1
#define Current_Cell7_GPIO_Port GPIOB
