usern4mehere9/LVPSU/(commit log)

2026-01-19 Initial commit
    Blank KiCad files for later use
    [LV_Kontrola_Main.kicad_pcb, LV_Kontrola_Main.kicad_sch, LV_Regulator.kicad_pcb, LV_Regulator.kicad_sch]
2026-01-19 Folder structure added
    Added a folder structure for documentation, code and component data; Added basic info to KiCad files
    [LV_Kontrola_Main.kicad_pcb, LV_Kontrola_Main.kicad_sch, LV_Regulator.kicad_pcb, LV_Regulator.kicad_sch]
2026-01-20 Added components
    Added some basic isolation components to the LV_Regulator schematic.
    [41.52.9.005.0010.stp, 415290050010.psm, EDI2CAP.CFG, LV_Regulator.kicad_sch, SOIC127P1030X265-16N.PcbLib, UCC12040DVE.SchLib, UCC12040DVE.stp, chips.prt]
2026-01-20 Modified LV_Regulator schematic; Added basic code configuration for LV_Reulator
    Added the MCU to the schematic and some basic passives around it;
    Added the basic STM32 program structure and set up the pin configuration to reflect the schematic.
    [LV_Regulator.kicad_sch]
2026-01-26 Created initial STM projects
    Created basic blank project and added some pin definitions
2026-01-31 Added LDOs
    Added the two LDOs for 3v3 and 5v logic supply.
    [LV_Regulator.kicad_sch, MCP1826T-ADJE_DC.step]
2026-02-03 Kicad Schematic Progress
    Put down basic components and imported TI FET's & Buck-Boost Controller, as well as some of the basic connections between Controller and FET's.
    [Buck_Boost_Controller.kicad_pcb, Buck_Boost_Controller.kicad_sch]
2026-02-03 Added a lot
    Created a schematic hierarchy for LV_Regulator, added connectors, added start logic, added address select jumpers for RS485, implemented start isolation on LV_Kontrola_Main,...
    [LV_Kontrola_Main.kicad_sch, LV_Regulator.kicad_sch, Start_3V3_Isolation.kicad_sch, Start_5V_Isolation.kicad_sch, isolation.kicad_sch, logic_supply.kicad_sch, mcu.kicad_sch, regulator.kicad_sch]
2026-02-03 Kicad Regulator & Buck Boost controller Schematic Progress
    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
    [Buck_Boost_Controller.kicad_pcb, Buck_Boost_Controller.kicad_sch, regulator.kicad_sch]
2026-02-05 Fixed last commit
    Fixed all mistakes from the last push
    [mcu.kicad_sch, regulator.kicad_sch]
2026-02-05 Added Start Control
    Added Start Control MCU to the LV_Kontrola_Main, added hsc/lsc to LV_Regulator, fixed component numbering
    [LV_Kontrola_Main.kicad_sch, isolation.kicad_sch, logic_supply.kicad_sch, regulator.kicad_sch, start_control.kicad_sch]
2026-02-09 Added Stat logic
    Added start mcu and associated components to the LV_Kontrola_Main schematic, added STM32CubeIDE project and basic configuration, added fuses to LV_Regulator
    [isolation.kicad_sch, logic_supply.kicad_sch, start_control.kicad_sch]
2026-02-10 Continuation of BQ25858 Schematic drawing
    Added more components from the examples schematic provided from TI.
    [regulator.kicad_sch]
2026-03-03 LV_Regulator Control changes
    Added debug and development equipment, added config. eeprom, more...
    [2169890001.step, Board_layout_draft.dwg, isolation.kicad_sch, logic_supply.kicad_sch, mcu.kicad_sch]
2026-03-11 Update & Further Progress on Regulator Controller Schematic
    Nikola Popovic added Frequency choice jumpers
    I added Jumpers for Voltage trigger selection
    Made global Labels for MCU pin connection, connected PG & STAT Diodes as well as connected ACN & ACP pins.
    [regulator.kicad_sch]
2026-03-11 Update Schematic, moved MOSFETS box
    [regulator.kicad_sch]
2026-03-11 Updated Note for Regulator
    [regulator.kicad_sch]
2026-03-12 Regulator Update & MCU pins
    Update schematic and connected Regulator to MCU
    [mcu.kicad_sch, regulator.kicad_sch]
2026-03-16 added certain footprints
    Added footprints for certain parts such as the BQ25858Q1 regulator controller & CSD19506 MOSFET for PCB design and put in footprints (will need change)
    [mcu.kicad_sch, regulator.kicad_sch]
2026-03-17 Various changes
    [LV_Kontrola_Main.kicad_sch, Start_Power.kicad_sch, start_control.kicad_sch]
2026-03-17 Multiple Footprints Added
    [isolation.kicad_sch, mcu.kicad_sch, regulator.kicad_sch]
2026-03-18 Changes of PCB and Schematic files for the LV_Regulator
    Removed old LDOs, added new LDOs, defined initial pcb size and I/O ports
    [EDI2CAP.CFG, LV_Regulator.kicad_pcb, MCP1826T-ADJE_DC.step, MIC29152WU.PcbLib, MIC29152WU.SchLib, MIC29152WU.stp, chips.prt, logic_supply.kicad_sch]
2026-03-20 Update to LV_Regulator schematic
    Chosen some component's footprints as well as made a page for test points, etc.
    [EDI2CAP.CFG, FCSL110R005FER.SchLib, FCSL110R005FER.stp, LV_Regulator.kicad_sch, RESC50110X70N.PcbLib, chips.prt, mcu.kicad_sch, regulator.kicad_sch]
2026-03-20 Multiple Updates
    Added footprints and purchase links to the MCU page and updated some footprints on the Regulator Page from smd to SMD Handsolder
    [mcu.kicad_sch, regulator.kicad_sch]
2026-03-20 Added footprints and Test points
    Added test points, yet to connect them have to find where they all go exactly
    [isolation.kicad_sch, logic_supply.kicad_sch, regulator.kicad_sch, test_points.kicad_sch]
2026-03-27 Added Footprints & Links for Component Purchase
    [EDI2CAP.CFG, SODFL3718X108N.PcbLib, V1FM10-M3_H.SchLib, V1FM10-M3_H.stp, chips.prt, isolation.kicad_sch, logic_supply.kicad_sch, mcu.kicad_sch]
2026-03-28 PCB Layout definitions part 2
    Added isolation keepouts
    [LV_Regulator.kicad_pcb]
2026-03-28 Halfway Push of adding 3D models to PCB layout components
    Pushing with components left to add to finish on main PC
    [430450401--3DModel-STEP-269445.STEP, 430450800--3DModel-STEP-56544.STEP, KTT0002A.stp, LV_Regulator.kicad_pcb, QFN-36-1EP_5x6mm_P0.5mm_EP3.6x4.6mm.step, Texas_RHH0036C_VQFN-36-1EP_6x6mm_P0.5mm_EP4.4x4.4mm.step, isolation.kicad_sch, logic_supply.kicad_sch]
2026-03-29 Added 3D models to components part 2
    Modeled some Custom .step models for components whose 3D models I couldn't find, and imported the rest.
    [LV_Regulator.kicad_pcb, SC32A-6PF20PPM.stp, Schottky Diode.step, UCZ1J181MNS1MS_Vibration_resistant.step]
2026-03-31 Initial Routing for tje LV_Regulator control portion
    Changes to the schematic were made for simpler routing
    [LV_Regulator.kicad_pcb, isolation.kicad_sch, mcu.kicad_sch]
2026-04-03 LV Regulator Switching layout Started
    Rough placement of components bigger components, a well as giving a capacitor a 3D model it lacked for the 3D View.
    More precise placement is in queue and actual PCB routing.
    [LV_Regulator.kicad_pcb, regulator.kicad_sch, test_points.kicad_sch]
2026-04-04 Component Placement and Routing
    [LV_Regulator.kicad_pcb, test_points.kicad_sch]
2026-04-07 Continued PCB Routing
    [LV_Regulator.kicad_pcb, test_points.kicad_sch]
2026-04-07 PCB routing and TP placement
    Finished first PCB routing and started TP placement
    [LV_Regulator.kicad_pcb, test_points.kicad_sch]
2026-04-07 Changes to LV_Kontrola_Main
    Added a lot to the schematic, fixed component libs, mics...
    [2169890001.step, 430450401--3DModel-STEP-269445.STEP, 430450800--3DModel-STEP-56544.STEP, 430451600.step, EDI2CAP.CFG, LV_Kontrola_Main.kicad_sch, MIC29152WU.PcbLib, MIC29152WU.SchLib]
2026-04-08 Deleted Draft Regulator and Test Points Routing
    Deleted Draft Routing of the Regulator and Power Electronics side of the board, because layout was not optimal in the slightest, & will replace and re-route the whole power electronics side.
    [LV_Regulator.kicad_pcb, test_points.kicad_sch]
2026-04-08 Multiple Fixes in Schematic & Routing
    Fixed multiple issues in schematic, like adding jumpers to isolate ACUV/ACOV between the choices. Moved the fuses on the Logic_Supply as per instruction of professor from Chair of Electronics, FoTS, UoNS. Started and made good progress on Power Electronics (Regulator Side) of the PCB.
    [LV_Regulator.kicad_pcb, logic_supply.kicad_sch, regulator.kicad_sch]
2026-04-14 Small corrections to the control part of LV_Regulatoe
    Changes to the PCB.
    [LV_Regulator.kicad_pcb]
2026-04-14 PCB Routing
    Did some PCB Routing, added components for 5V Logic regulator, some routing around the BQ25858 IC, will probably need clean up.
    [LV_Regulator.kicad_pcb]
2026-04-28 PCB Routing progress
    [LV_Regulator.kicad_pcb]
2026-05-14 Major PCB Routing Progress
    Finished routing of all Regulator & Power components and connections.
    Also routed & placed a good amount of power electronics side TP's, only a few left which are Logic Supply TP's and the MCU side TP's.
    Only Routing on the Power side left are the few remaining test points.
    Additional detail, removed all Teardrops because of their deletion residue, in doing so, I've also removed all the residue.
    Tear drops will be added after final routing for the revision has been finished.
    [LV_Regulator.kicad_pcb, LV_Regulator.kicad_sch, isolation.kicad_sch, logic_supply.kicad_sch, mcu.kicad_sch, regulator.kicad_sch, test_points.kicad_sch]
2026-05-17 Redesigned the control section of the LV_Regulator
    The routing of the control section was redone completely, LED's were labeled with their function, some signals were renamed for consistency, removed redundant testpoints, removed names of testpoints, changed configuration jumpers to have human reada
    [LV_Regulator.kicad_pcb, mcu.kicad_sch, test_points.kicad_sch]
2026-05-17 Folder structure changes
    The folder structures were changed to comply with current FS Black Hornets GitHub repository templates. Separated out all the elements of the LV_Kontrola subsystem.
    [2169890001.step, 41.52.9.005.0010.stp, 415290050010.psm, 430450401--3DModel-STEP-269445.STEP, 430450800--3DModel-STEP-56544.STEP, 430451600.step, EDI2CAP.CFG, FCSL110R005FER.SchLib]
2026-05-17 Fixed some readmes
    Fixed some readmes to comply with some parts of the FS Black Hornets repository template. (Parts required for the overall schematic)
2026-05-18 Fixed DRC & some other minor tweaks
    [LV_Regulator.kicad_pcb, isolation.kicad_sch, logic_supply.kicad_sch, mcu.kicad_sch, regulator.kicad_sch, test_points.kicad_sch]
2026-05-19 Started BOM work
    [LV_Regulator-B_Cu.gbr, LV_Regulator-B_Mask.gbr, LV_Regulator-B_Paste.gbr, LV_Regulator-B_Silkscreen.gbr, LV_Regulator-Edge_Cuts.gbr, LV_Regulator-F_Cu.gbr, LV_Regulator-F_Mask.gbr, LV_Regulator-F_Paste.gbr]
2026-06-01 PCB changes
    Changes to the silkscreen of the pcb, added mounting holes, modified the schematic to comply with the template, more...
    [LV_Regulator.kicad_pcb, LV_Regulator.kicad_sch, isolation.kicad_sch, logic_supply.kicad_sch, mcu.kicad_sch, regulator.kicad_sch, test_points.kicad_sch]
2026-06-01 Finished BoM Sheet, Fixed Component issues.
    Fixed DRC Errors, as well as changing a Capacitor that was not chosen correctly. And have filled Bill of Materials.
    [LV_Regulator.kicad_pcb, LV_Regulator_BoM.xlsx, regulator.kicad_sch]
2026-06-01 Fixed Capacitor choice
    Mixed up Capacitor choices, fixed the issue
    [LV_Regulator.kicad_pcb, LV_Regulator_BoM.xlsx, regulator.kicad_sch]
2026-06-02 Finished BoM
    [LV_Regulator_BoM.xlsx]
2026-06-02 Added graphics to PCB
    [LV_Regulator.kicad_pcb]
2026-06-05 Started LV_Kontrola_Start pcb
    [LV_Kontrola_Start.kicad_pcb, LV_Regulator_BoM.xlsx, Start_5V_Isolation.kicad_sch, Start_Power.kicad_sch]
