usern4mehere9/LVPSU/(notices)

Notices in the files:
LV_Regulator/LV_Regulator/Components/ul_BQ25858QWRRVRQ1/QFN-36-1EP_5x6mm_P0.5mm_EP3.6x4.6mm.step:
Copyright (C) 2017, kicad StepUp
This program is free software: you can redistribute it and/or modify
it under the terms of the GNU General Public License as published by
the Free Software Foundation, either version 3 of the License, or
any later version.
itself might be covered by the GNU General Public License.
LV_Regulator/LV_Regulator/Components/ul_BQ25858QWRRVRQ1/Texas_RHH0036C_VQFN-36-1EP_6x6mm_P0.5mm_EP4.4x4.4mm.step:
Copyright (C) 2024, KiCAD
This work is licensed under the
[Creative Commons CC-BY-SA 4.0 License](https://creativecommons.org/licenses/by-sa/4.0/legalcode),
with the following exception:
project files under this or any other license agreement. However, if you wish to distribute
LV_Kontrola_Main/LV_Kontrola_Infeed_Bat/Code/LV_Kontrola_Main_Analogni/Core/Inc/main.h:
Copyright (c) 2026 STMicroelectronics.
All rights reserved.
This software is licensed under terms that can be found in the LICENSE file
LV_Kontrola_Main/LV_Kontrola_Start/LV_Kontrola_Start/Components/430451600/430451600.step:
FILE_NAME( 'C:/Users/KMIROS~1/AppData/Local/Temp/psolqas_22460_44.stp', '2020-07-09T08:06:22', ( 'License CC BY-ND 4.0' ), ( 'CADENAS' ), ' ', 'PARTsolutions', ' ' );
